RolandWa/ad8317_powermeter/emerge_results/golden/run_20260810_010924/README.md

# Golden Baseline

- Timestamp: 2026-08-10 01:09:24
- Source: User-confirmed EMerge plugin run
- Purpose: Golden reference for geometry, mesh, and result artifact comparison
- Main log file: emerge_e2e_20260810_010924_golden.log
- Touchstone: ad8317_powermeter.s2p
- Notes: This baseline includes AOI-filtered vias and explicit via geometry generation.
