RolandWa/ad8317_powermeter/doc/diagrams/out/emerge_plugin_pipeline.png

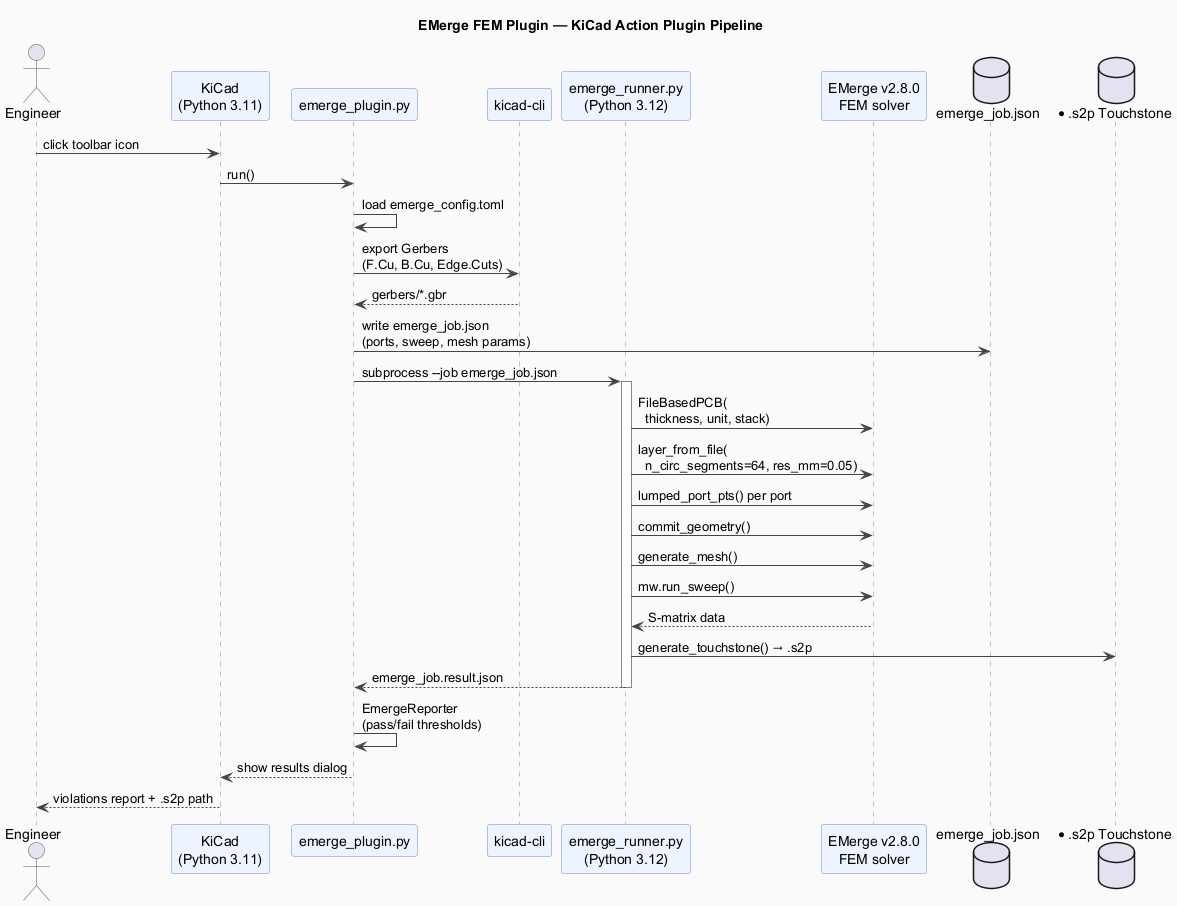
doc/diagrams/out/emerge_plugin_pipeline.png
