RolandWa/ad8317_powermeter/doc/diagrams/out/firmware_architecture.png

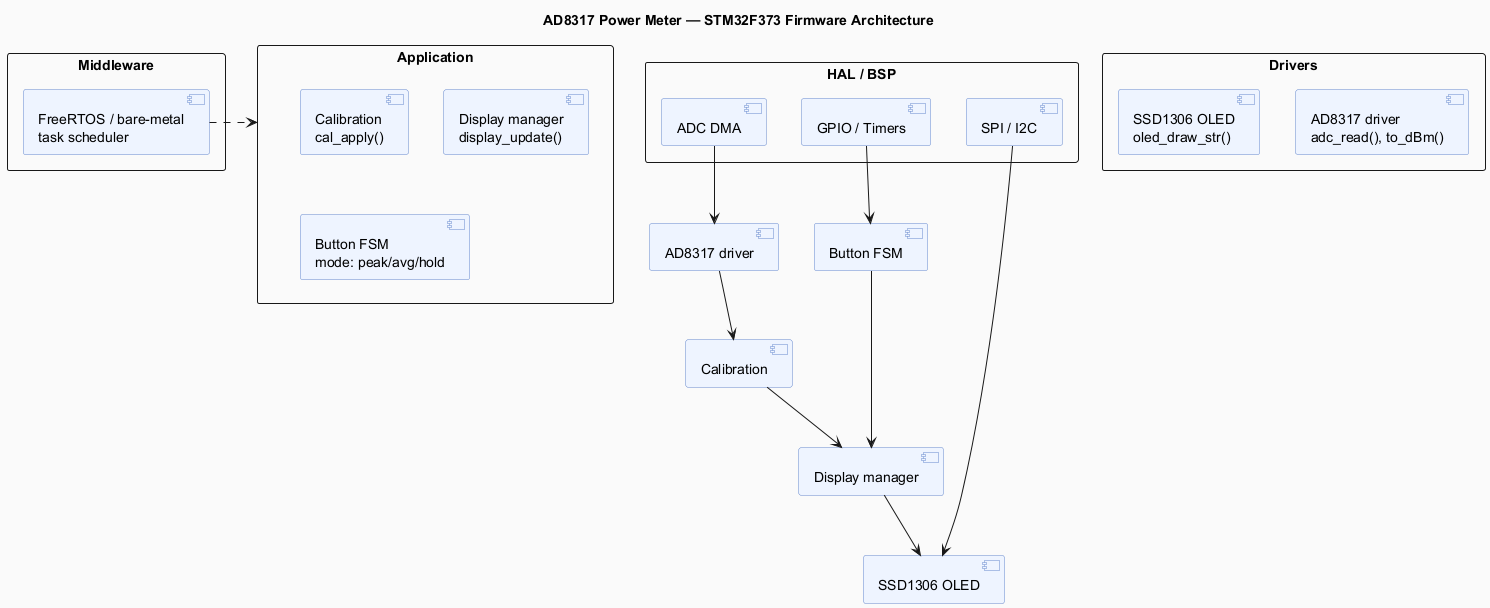
doc/diagrams/out/firmware_architecture.png
