RolandWa/ad8317_powermeter/kicad/fixture-rev_A/ad8317_powermeter-fixture.png

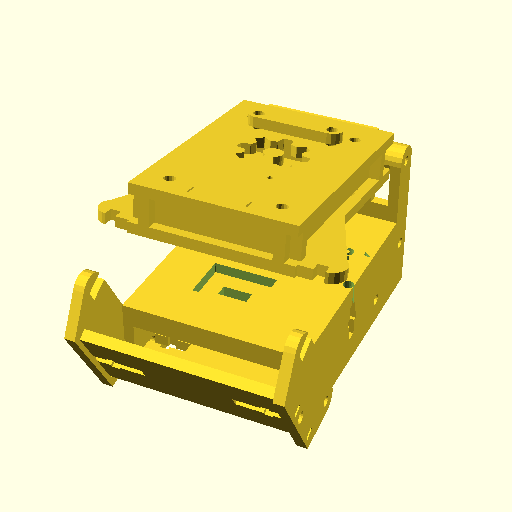
kicad/fixture-rev_A/ad8317_powermeter-fixture.png
