RolandWa/ad8317_powermeter/sim/qucs/adl5507_vs_ad8317_board.png

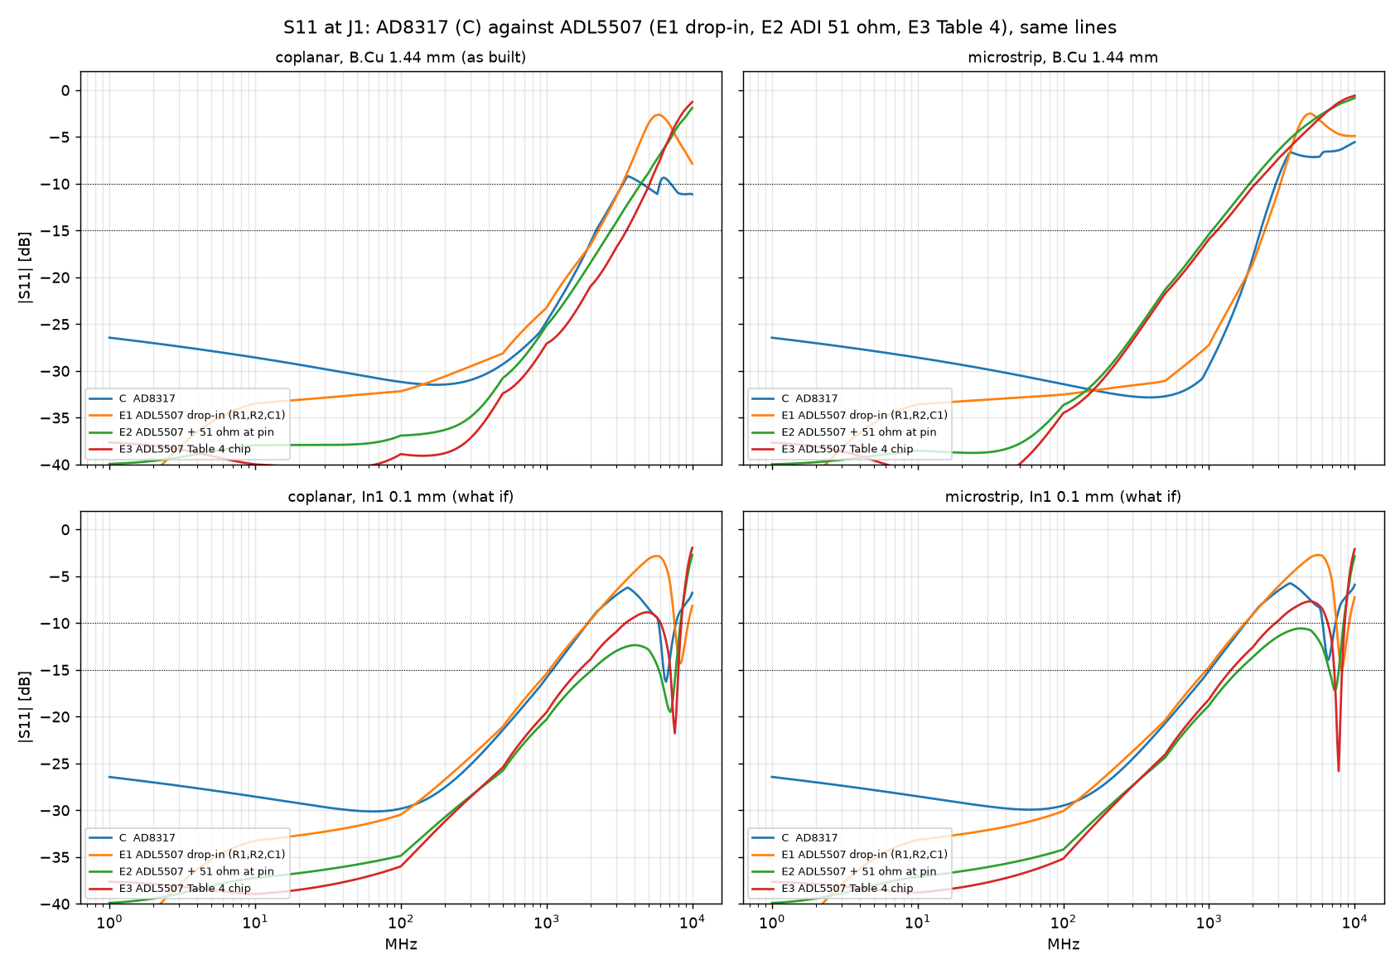
sim/qucs/adl5507_vs_ad8317_board.png
