RolandWa/ad8317_powermeter/sim/qucs/s11_1MHz_10GHz.png

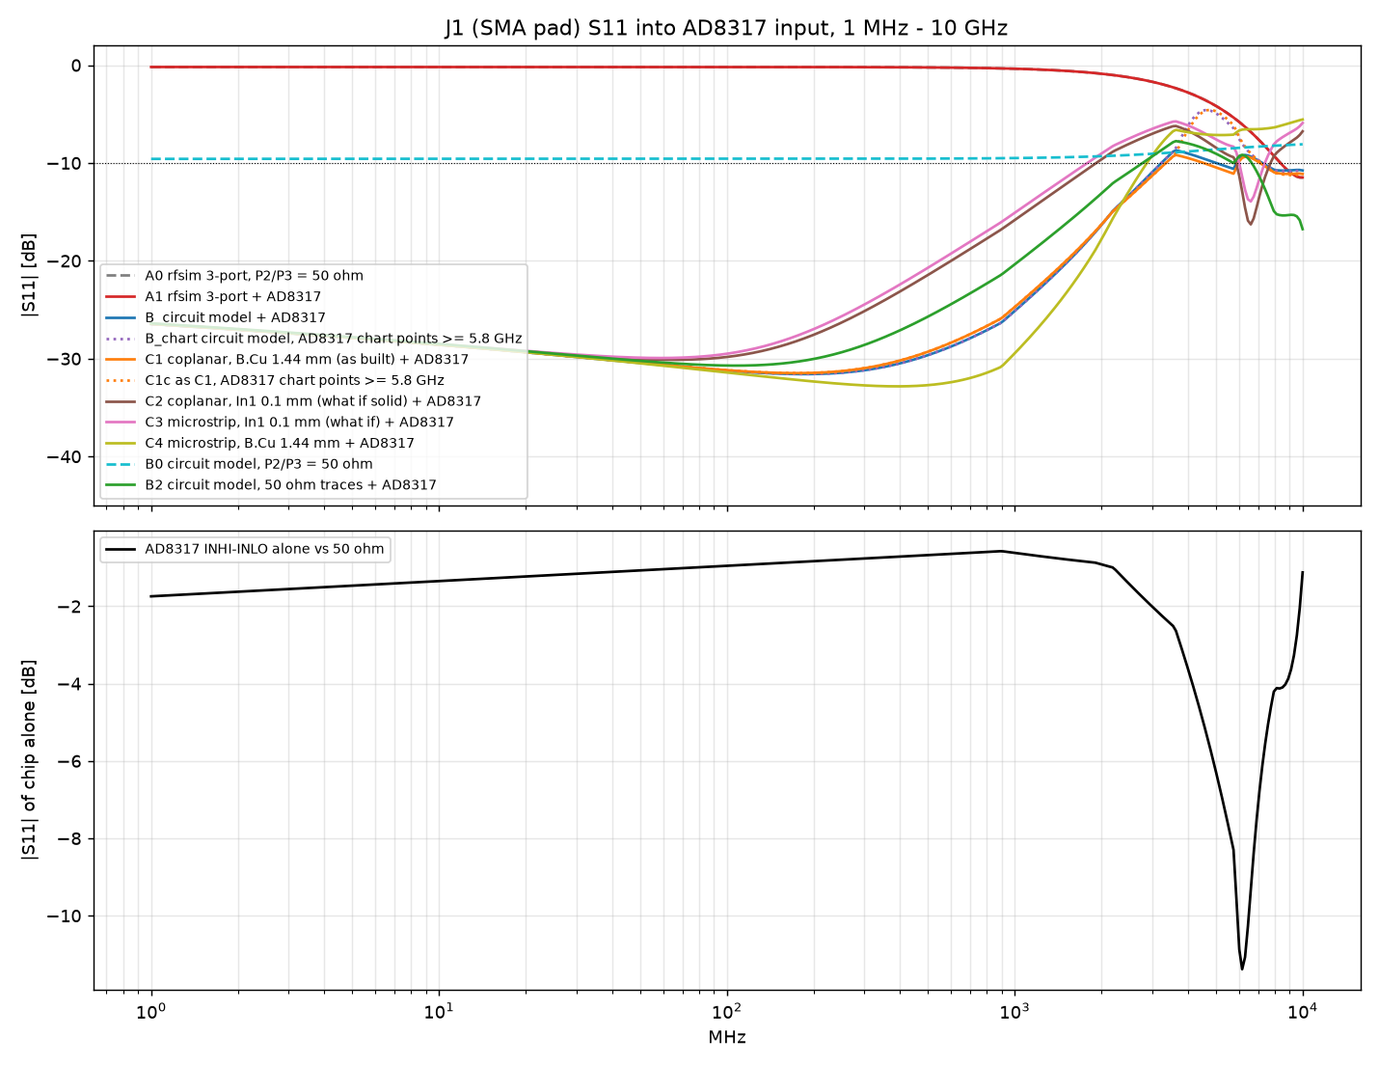
sim/qucs/s11_1MHz_10GHz.png
