RolandWa/ad8317_powermeter/sim/qucs/s11_optimized_geom_shunt_1MHz_10GHz.png

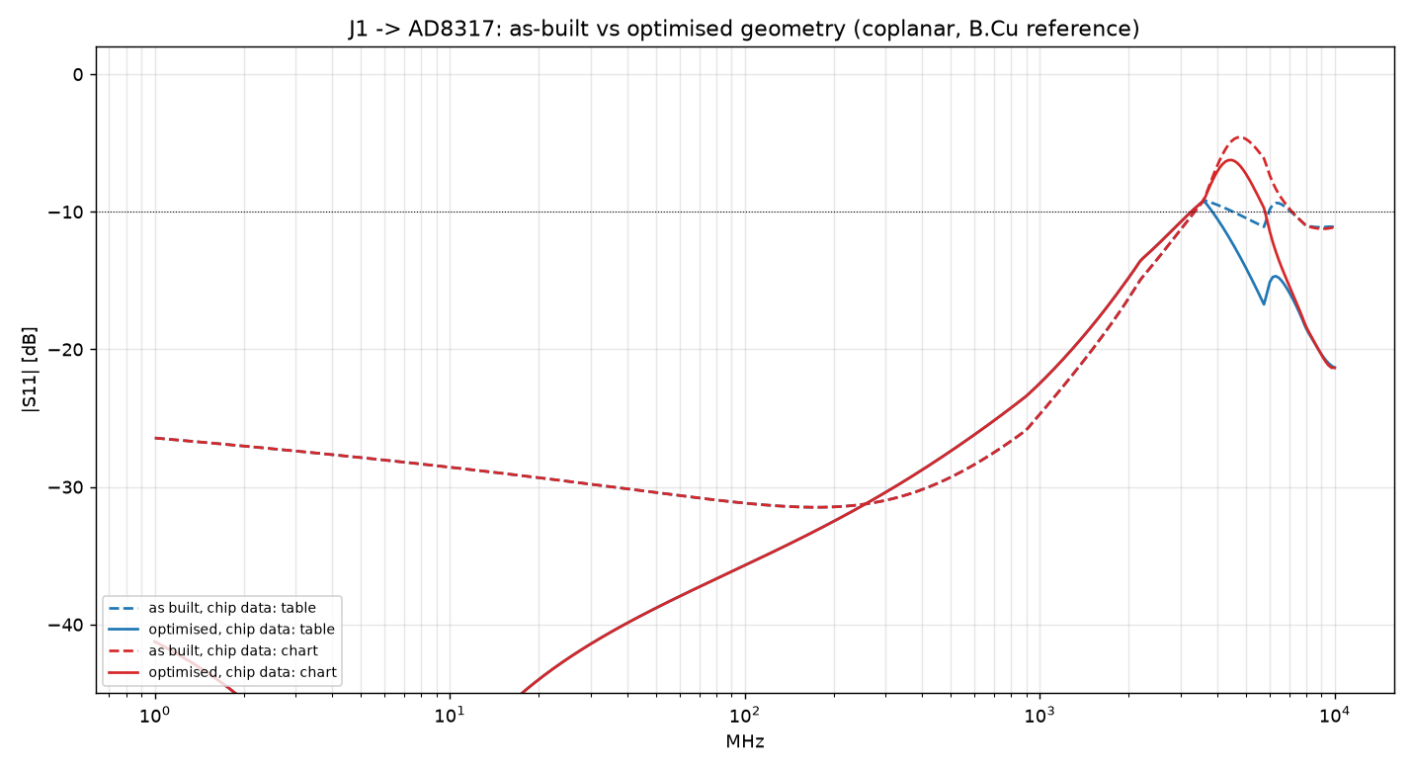
sim/qucs/s11_optimized_geom_shunt_1MHz_10GHz.png
