RolandWa/ad8317_powermeter/kicad/jlcpcb/production_files/BOM-ad8317_powermeter.csv

Comment | Designator | Footprint | LCSC | Quantity
0R | R13 | R_0402_1005Metric | C140225 | 1
100R | R1,R2 | R_0402_1005Metric | C25076 | 2
100k | R17,R18,R19,R22,R8 | R_0402_1005Metric | C25530 | 5
100nF | C10,C13,C17,C18,C19,C25,C26,C27,C30,C4,C7,C9 | C_0402_1005Metric | C9900014224 | 12
10K | R20,R23,R6 | R_0402_1005Metric | C25531 | 3
10k NTC Thermistor | R16,R21 | C_0402_1005Metric | C2892547 | 2
10uF/ | C12,C14,C15,C16,C5,C8 | C_0805_2012Metric | C1713 | 6
10uF/16V | C28,C29 | C_0805_2012Metric | C77075 | 2
12k | R5 | R_0402_1005Metric | C25752 | 1
1k | R11,R3 | R_0402_1005Metric | C9900199398 | 2
1k5 | R14,R15 | R_0402_1005Metric | C269672 | 2
1nF / C0G | C3 | C_0402_1005Metric | C76947 | 1
1uF/ | C23,C24,C31,C32 | C_0402_1005Metric | C2887021 | 4
2k | R12 | R_0402_1005Metric | C140225 | 1
4.7uF | C11 | C_0805_2012Metric | C1779 | 1
47nF | C1,C2 | C_0402_1005Metric | C880605 | 2
5K1 | R10,R9 | R_0402_1005Metric_Pad0.72x0.64mm_HandSolder | C5913162 | 2
8.2pF / C0G | C6 | C_0402_1005Metric | C1579 | 1
AD8317 | U1 | LFCSP-8-1EP_2x3mm_P0.5mm_EP1.6x2.34mm | C578693 | 1
ADP150AUJZ-3.3-R7 | U4 | TSOT-23-5 | C42432300 | 1
AP2112K-3.3 | U6 | SOT-23-5 | C51118 | 1
BQ24092DGQ | U5 | HVSSOP-10-1EP_3x3mm_P0.5mm_EP1.83x1.89mm_ThermalVias | C2864890 | 1
Conn_01x02_Pin | J4 | JST_XH_B2B-XH-AM_1x02_P2.50mm_Vertical | C161869 | 1
LED | D1,D2 | LED_0402_1005Metric | C9900022508 | 2
M24C02-WMN | U7 | SOIC-8_3.9x4.9mm_P1.27mm | C7562 | 1
REF3030 | U3 | SOT-23 | C38423 | 1
TPD4E1U06 | U8 | SOT-23-6 | C124691 | 1
USB_C_Receptacle_USB2.0_16P | J2 | USB_C_Receptacle_G-Switch_GT-USB-7010ASV |  | 1
Small_Open | JP1 | SolderJumper-2_P1.3mm_Open_RoundedPad1.0x1.5mm |  | 1
0603USB-142 | FL1 | L_CommonModeChoke_Coilcraft_0603USB |  | 1
Conn_ARM_JTAG_SWD_10_UART | J5 | PinHeader_2x05_P1.27mm_Vertical_SMD |  | 1
SW_Omron_B3FS | SW1 | SW_SPST_Omron_B3FS-100xP |  | 1
STM32F373RCTx | U2 | LQFP-64_10x10mm_P0.5mm |  | 1
Boot0 | JP2 | SolderJumper-2_P1.3mm_Open_RoundedPad1.0x1.5mm |  | 1
SW_Omron_B3FS | SW2 | SW_SPST_Omron_B3FS-100xP |  | 1
2A max / 8V max | F1 | Fuse_1812_4532Metric_Pad1.30x3.40mm_HandSolder |  | 1
RFShield_OnePiece | J6 | Laird_Technologies_BMI-S-101_13.66x12.70mm_custom |  | 1
