RolandWa/ad8317_powermeter/mech/levers/assembly_check.step

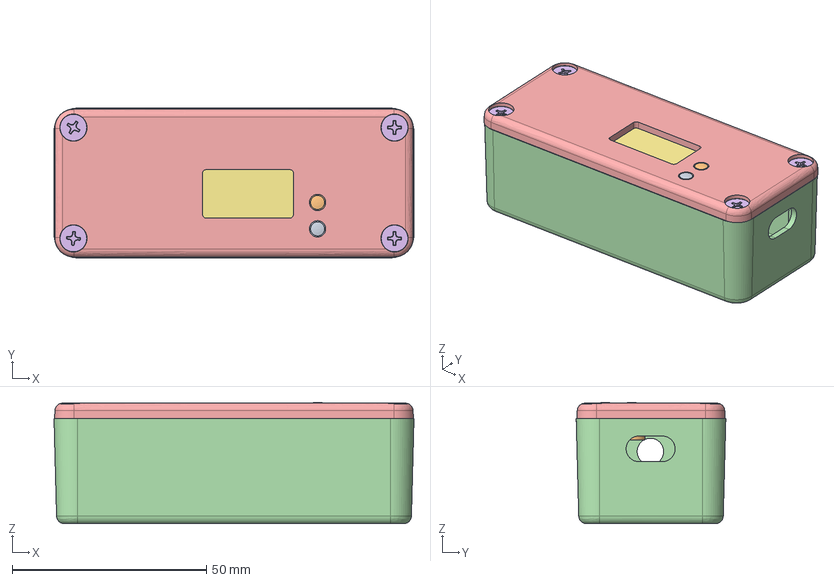
[picture p53: CAD file, 2026-10-23]
mech/levers/assembly_check.step
92.6 x 38.5 x 31.2 mm
lever_menu_SW1
lever_next_SW2
lever_bracket
case_machined
oled_module_envelope
