RolandWa/ad8317_powermeter/kicad/fixture-rev_A/ad8317_powermeter-test.dxf

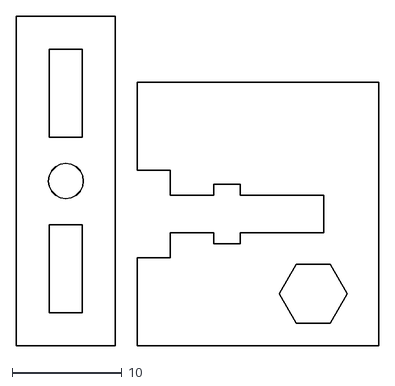
[picture p54: CAD file, 2026-08-02]
kicad/fixture-rev_A/ad8317_powermeter-test.dxf
33.0 x 30.0
