RolandWa/ad8317_powermeter/mech/cnc_wall_left_SMA.dxf

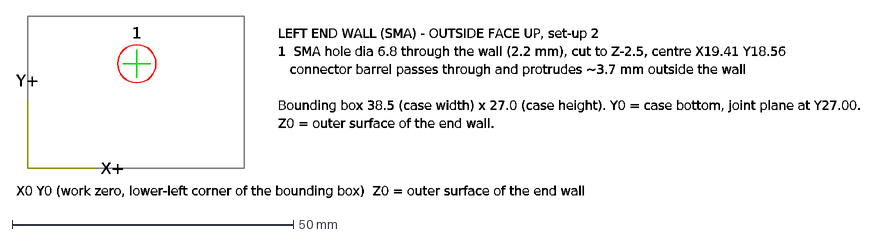
[picture p55: CAD file, 2026-10-23]
mech/cnc_wall_left_SMA.dxf
1
LEFT END WALL (SMA) - OUTSIDE FACE UP, set-up 2
1 SMA hole dia 6.8 through the wall (2.2 mm), cut to Z-2.5, centre X19.41 Y18.56
connector barrel passes through and protrudes ~3.7 mm outside the wall
Bounding box 38.5 (case width) x 27.0 (case height). Y0 = case bottom, joint plane at Y27.00.
Z0 = outer surface of the end wall.
X+
Y+
X0 Y0 (work zero, lower-left corner of the bounding box) Z0 = outer surface of the end wall
