RolandWa/ad8317_powermeter/mech/levers/levers.3mf

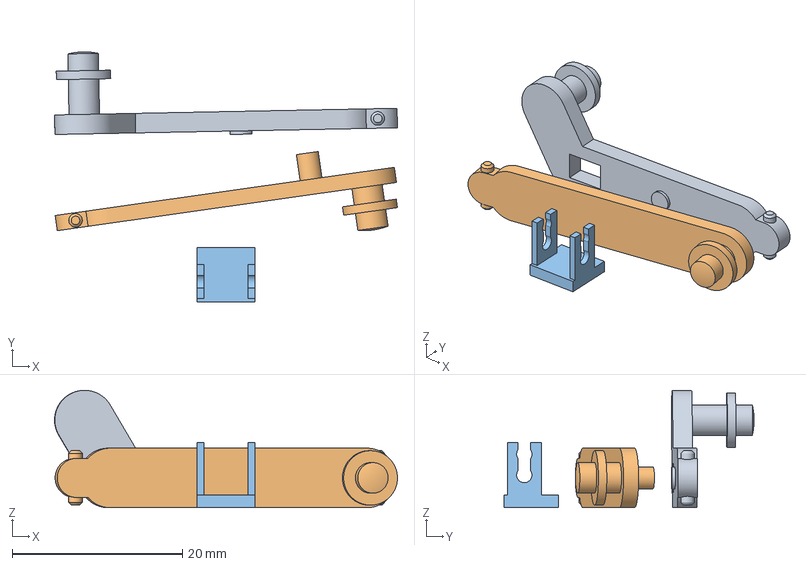
[picture p56: CAD file, 2026-10-23]
mech/levers/levers.3mf
40.3 x 29.4 x 13.8 mm
