RolandWa/ad8317_powermeter/kicad/fixture-rev_A/ad8317_powermeter-track.dxf

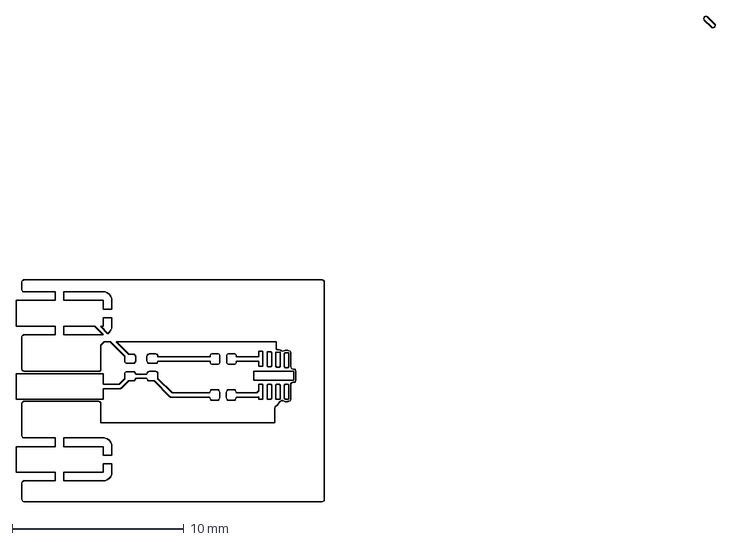
[picture p57: CAD file, 2026-08-02]
kicad/fixture-rev_A/ad8317_powermeter-track.dxf
40.7 x 28.2 mm
