RolandWa/ad8317_powermeter/mech/hammond_1590A_machined.step

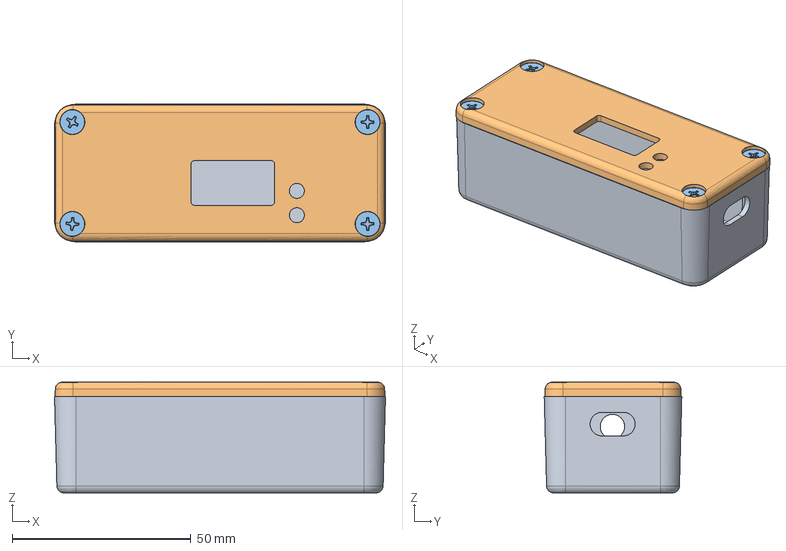
[picture p58: CAD file, 2026-10-23]
mech/hammond_1590A_machined.step
92.6 x 38.5 x 31.0 mm
