RolandWa/ad8317_powermeter/mech/levers/lever_menu_SW1.step

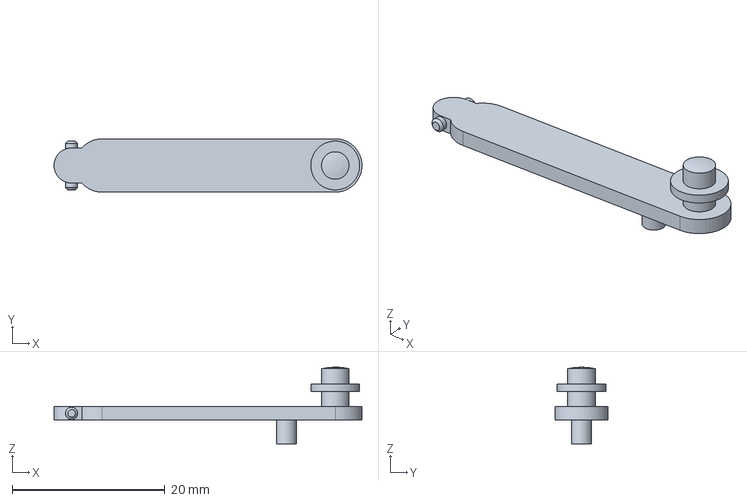
[picture p59: CAD file, 2026-10-23]
mech/levers/lever_menu_SW1.step
40.3 x 7.00 x 10.1 mm
