RolandWa/ad8317_powermeter/kicad/fixture-rev_A/ad8317_powermeter-outline.dxf

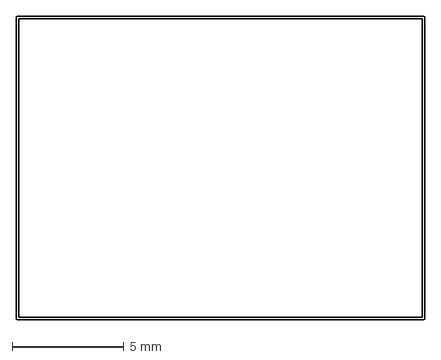
[picture p60: CAD file, 2026-08-02]
kicad/fixture-rev_A/ad8317_powermeter-outline.dxf
18.3 x 13.6 mm
