RolandWa/ad8317_powermeter/mech/cnc_wall_right_USB.dxf

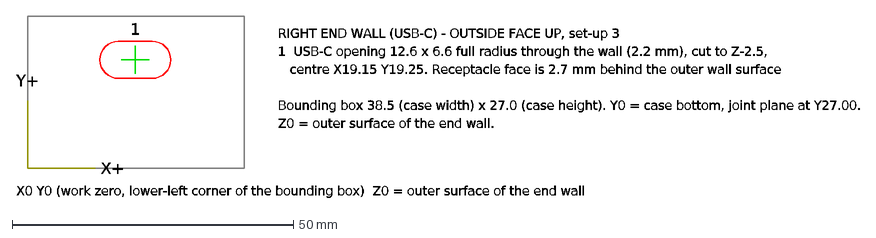
[picture p61: CAD file, 2026-10-23]
mech/cnc_wall_right_USB.dxf
1
RIGHT END WALL (USB-C) - OUTSIDE FACE UP, set-up 3
1 USB-C opening 12.6 x 6.6 full radius through the wall (2.2 mm), cut to Z-2.5,
centre X19.15 Y19.25. Receptacle face is 2.7 mm behind the outer wall surface
Bounding box 38.5 (case width) x 27.0 (case height). Y0 = case bottom, joint plane at Y27.00.
Z0 = outer surface of the end wall.
X+
Y+
X0 Y0 (work zero, lower-left corner of the bounding box) Z0 = outer surface of the end wall
