RolandWa/ad8317_powermeter/kicad/fixture-rev_A/ad8317_powermeter-fixture.dxf

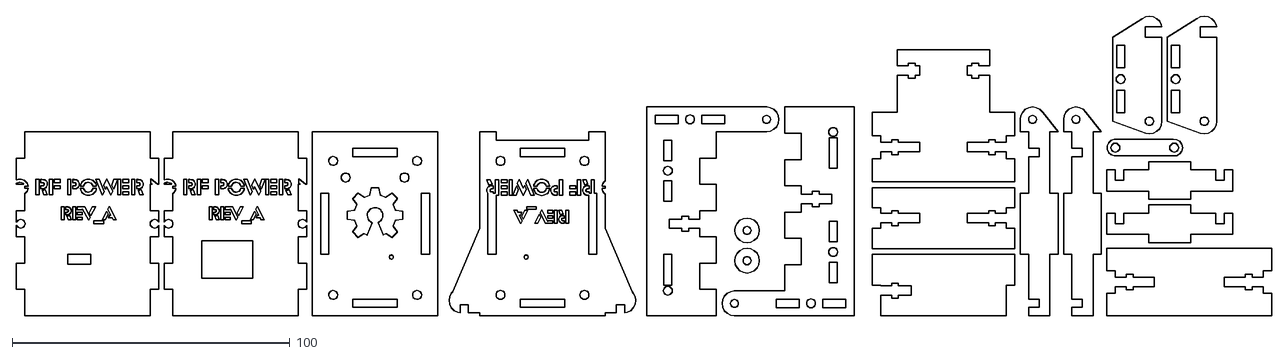
[picture p62: CAD file, 2026-08-02]
kicad/fixture-rev_A/ad8317_powermeter-fixture.dxf
451.5 x 107.7
