RolandWa/ad8317_powermeter/mech/cnc_lid_top.dxf

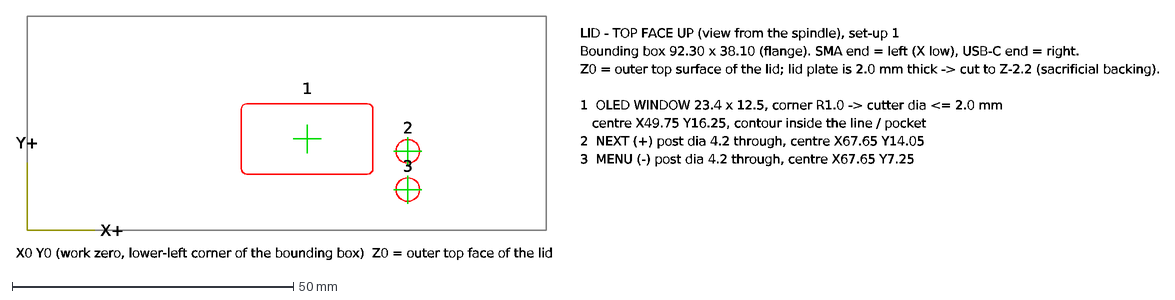
[picture p63: CAD file, 2026-10-23]
mech/cnc_lid_top.dxf
2
3
1
LID - TOP FACE UP (view from the spindle), set-up 1
Bounding box 92.30 x 38.10 (flange). SMA end = left (X low), USB-C end = right.
Z0 = outer top surface of the lid; lid plate is 2.0 mm thick -> cut to Z-2.2 (sacrificial backing).
1 OLED WINDOW 23.4 x 12.5, corner R1.0 -> cutter dia <= 2.0 mm
centre X49.75 Y16.25, contour inside the line / pocket
2 NEXT (+) post dia 4.2 through, centre X67.65 Y14.05
3 MENU (-) post dia 4.2 through, centre X67.65 Y7.25
X+
Y+
X0 Y0 (work zero, lower-left corner of the bounding box) Z0 = outer top face of the lid
