RolandWa/ad8317_powermeter/mech/levers/lever_next_SW2.step

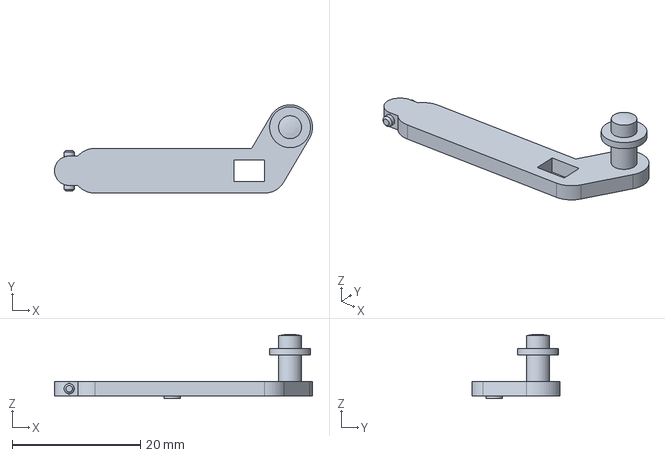
[picture p64: CAD file, 2026-10-23]
mech/levers/lever_next_SW2.step
40.3 x 13.8 x 10.1 mm
