RolandWa/ad8317_powermeter/mech/front_foil_1590A.dxf

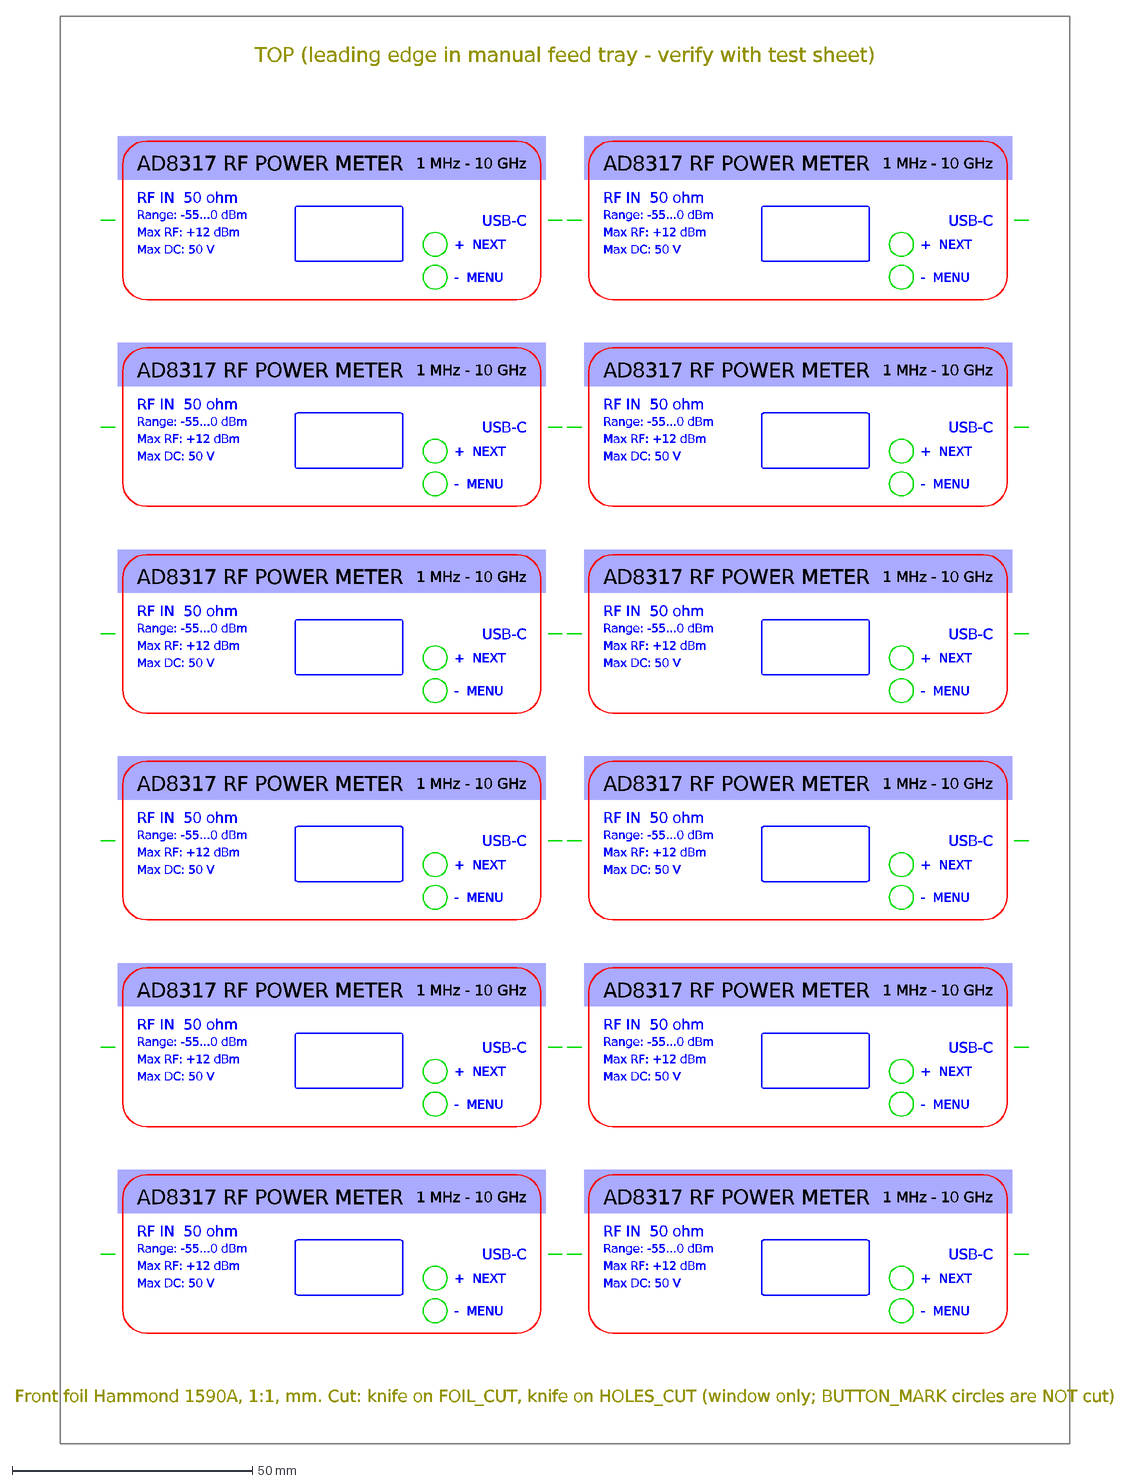
[picture p65: CAD file, 2026-10-23]
mech/front_foil_1590A.dxf
AD8317 RF POWER METER
1 MHz - 10 GHz
RF IN 50 ohm
Range: -55...0 dBm
Max RF: +12 dBm
Max DC: 50 V
USB-C
+ NEXT
- MENU
TOP (leading edge in manual feed tray - verify with test sheet)
Front foil Hammond 1590A, 1:1, mm. Cut: knife on FOIL_CUT, knife on HOLES_CUT (window only; BUTTON_MARK circles are NOT cut)
