RolandWa/ad8317_powermeter/mech/levers/lever_bracket.step

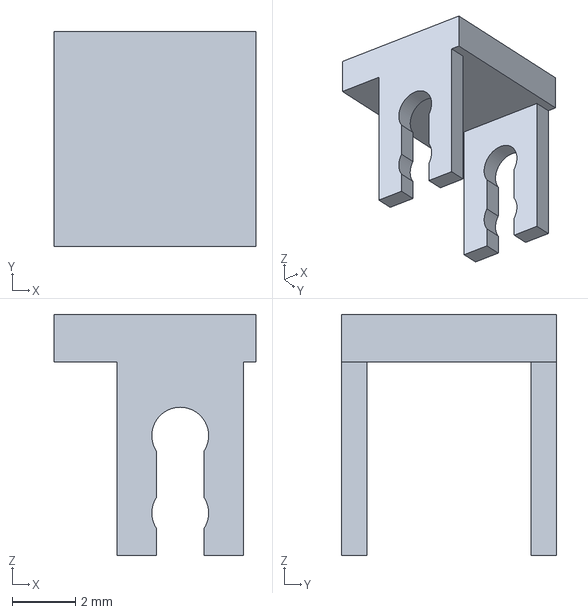
[picture p66: CAD file, 2026-10-23]
mech/levers/lever_bracket.step
6.40 x 6.80 x 7.64 mm
