RolandWa/ad8317_powermeter/(list of files, cad)

Other CAD files:
mech/levers/levers.gcode.3mf
mech/levers/lever_bracket.stl
mech/levers/lever_menu_SW1.stl
mech/levers/lever_next_SW2.stl
