RolandWa/ad8317_powermeter/mech/front_foil_1590A_test_sheet_A4.pdf

# TOP

# THIS SIDE = PRINTED SIDE (face F)

1. Take a plain A4 sheet. With a pencil draw a small arrow on ONE face, at the edge you will insert FIRST into the manual tray (this face = 'F', arrow = leading edge).
2. Load it in the manual tray exactly as you plan to load the foil
(e.g. face F up/down as the tray requires, arrow edge towards the printer).
3. Print this PDF at 100 % scale, colour.
4. Result: if the printed TOP arrow is at the pencil-arrow edge AND the print is on face F, the loading is correct. Otherwise rotate 180 deg and/or flip, repeat.
5. Load the foil the same way. The printed TOP edge = top of the sheet of foils (foil layout on the print sheet is not symmetric: header text at the top).

bar = 100 mm (measure to check print scale)
