RolandWa/ad8317_powermeter/sim/Measured_source_impedance.txt

#	Frequency (Hz)	Impedance (Ohm)	Phase (Deg)	
1	1000	0,000560552734029978	4,82452711974702
1	1071,51930523761	0,0005416886922197	7,14209337070298
1	1148,15362149688	0,000533371841688483	7,04294605382029
1	1230,26877081238	0,000539849298208619	7,04213373788446
1	1318,25673855641	0,000538129396486326	8,27278908202941
1	1412,53754462275	0,000534765524195188	8,91391828894431
1	1513,56124843621	0,000524927278521026	10,7650150981778
1	1621,81009735893	0,000518067333592301	12,6218435007175
1	1737,80082874938	0,000563457570139584	16,3469953317383
1	1862,08713666287	0,000518272901595398	14,398555985846
1	1995,26231496888	0,000519917198883852	17,0568662664533
1	2137,96208950223	0,000514601319963502	16,2707135709588
1	2290,86765276777	0,000576133502340014	19,5856516145035
1	2454,70891568503	0,000596389846115746	21,8414402405361
1	2630,26799189538	0,000532884856934725	23,7168477170005
1	2818,38293126445	0,000541318612371868	26,7012920106756
1	3019,95172040202	0,000628944117556202	22,4937176599206
1	3235,93656929628	0,000573547161269501	28,2921698624638
1	3467,36850452532	0,000597200960721228	30,4654517183948
1	3715,35229097172	0,000619368975789402	31,6169105015001
1	3981,07170553497	0,000707127470434435	33,1952184102704
1	4265,79518801593	0,000658666852178837	32,4537477221939
1	4570,88189614875	0,000607535285895156	31,0642288773697
1	4897,78819368446	0,00065802335701887	34,3164048480271
1	5248,07460249772	0,000631190138287628	37,694095890147
1	5623,41325190349	0,000633797750820474	40,4545209404637
1	6025,59586074358	0,000665723443822306	43,8796093297793
1	6456,54229034656	0,000736064761026864	46,102881890377
1	6918,30970918936	0,000782103178029204	49,5549261550406
1	7413,10241300918	0,000851706901337979	51,2162462238737
1	7943,28234724281	0,000898955659891943	52,9247825025595
1	8511,38038202376	0,000947196650326792	50,2553545067154
1	9120,1083935591	0,00104276493305608	54,9674727922125
1	9772,37220955811	0,00109952852709957	56,0489569531524
1	10471,285480509	0,00119376421446782	56,8203613736253
1	11220,1845430196	0,0012856894876208	57,149986225213
1	12022,6443461741	0,00138201268098962	57,6040616579294
1	12882,4955169313	0,00149019184356974	57,2980602121534
1	13803,8426460288	0,00159326348179086	57,2581168269142
1	14791,0838816821	0,00171810849886565	57,1610545940367
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
