RolandWa/ad8317_powermeter/sim/qucs/s11_results.csv

freq_Hz | A0_dB | A1_dB | B_dB | B_chart_dB | C1_dB | C1c_dB | C2_dB | C3_dB | C4_dB | B0_dB | B2_dB
1.000000e+06 | -0.190 | -0.190 | -26.465 | -26.465 | -26.446 | -26.446 | -26.443 | -26.435 | -26.448 | -9.584 | -26.391
1.023293e+06 | -0.190 | -0.190 | -26.484 | -26.484 | -26.465 | -26.465 | -26.462 | -26.454 | -26.466 | -9.584 | -26.409
1.047129e+06 | -0.190 | -0.190 | -26.502 | -26.502 | -26.484 | -26.484 | -26.480 | -26.472 | -26.485 | -9.583 | -26.428
1.071519e+06 | -0.190 | -0.190 | -26.521 | -26.521 | -26.502 | -26.502 | -26.499 | -26.491 | -26.504 | -9.583 | -26.446
1.096478e+06 | -0.190 | -0.190 | -26.540 | -26.540 | -26.521 | -26.521 | -26.518 | -26.509 | -26.523 | -9.583 | -26.465
1.122018e+06 | -0.190 | -0.190 | -26.559 | -26.559 | -26.540 | -26.540 | -26.537 | -26.528 | -26.541 | -9.582 | -26.483
1.148154e+06 | -0.190 | -0.190 | -26.578 | -26.578 | -26.559 | -26.559 | -26.555 | -26.547 | -26.560 | -9.582 | -26.502
1.174898e+06 | -0.190 | -0.190 | -26.597 | -26.597 | -26.578 | -26.578 | -26.574 | -26.565 | -26.579 | -9.582 | -26.521
1.202264e+06 | -0.190 | -0.190 | -26.616 | -26.616 | -26.597 | -26.597 | -26.593 | -26.584 | -26.598 | -9.581 | -26.540
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
