RolandWa/ad8317_powermeter/cal/results/figures/fig2_slope_vs_freq.png

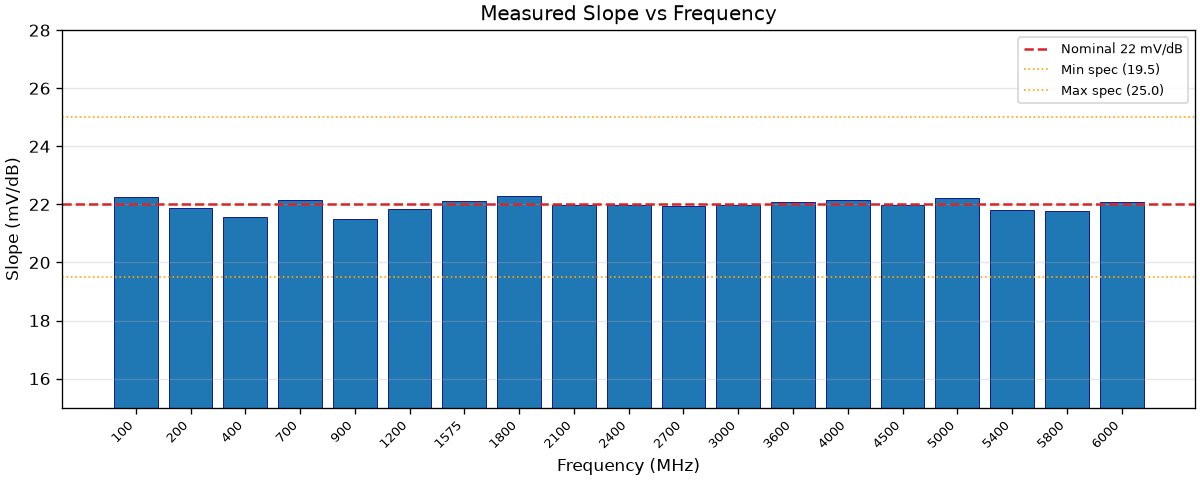
cal/results/figures/fig2_slope_vs_freq.png
