RolandWa/ad8317_powermeter/cal/results/figures/fig3_intercept_vs_freq.png

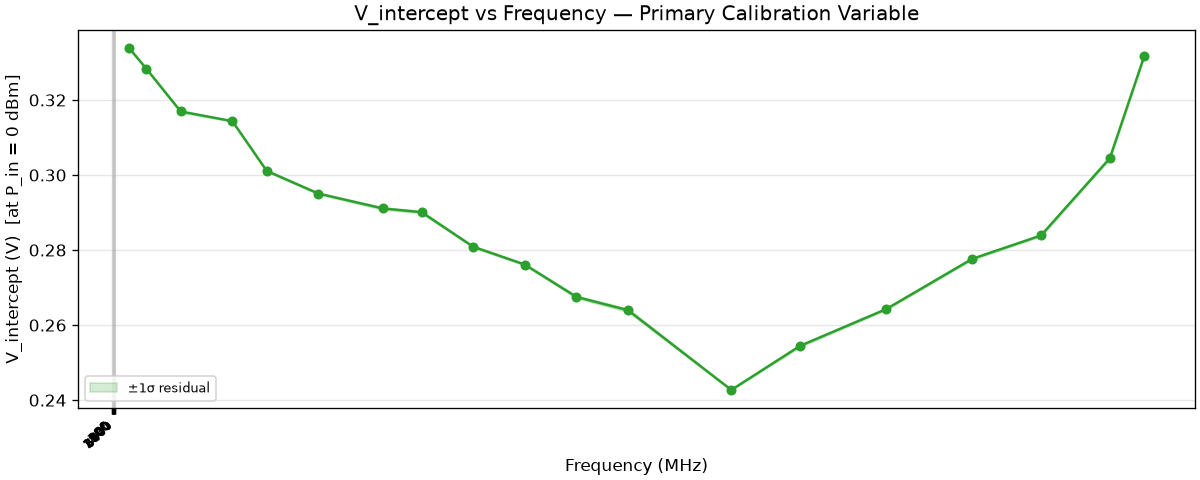
cal/results/figures/fig3_intercept_vs_freq.png
