RolandWa/ad8317_powermeter/cal/results/figures/fig4_residual_rms.png

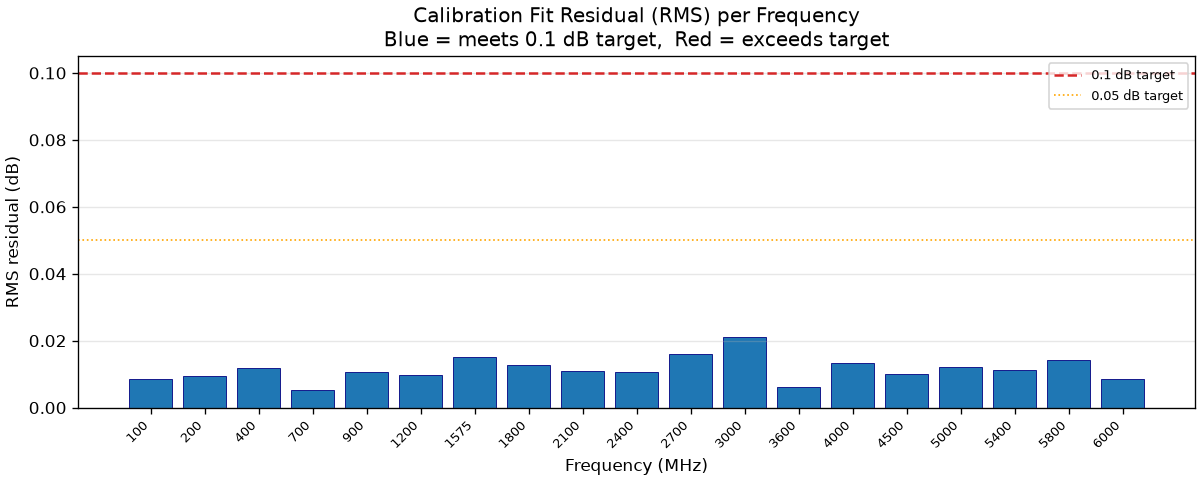
cal/results/figures/fig4_residual_rms.png
