RolandWa/ad8317_powermeter/cal/results/figures/fig5_error_heatmap.png

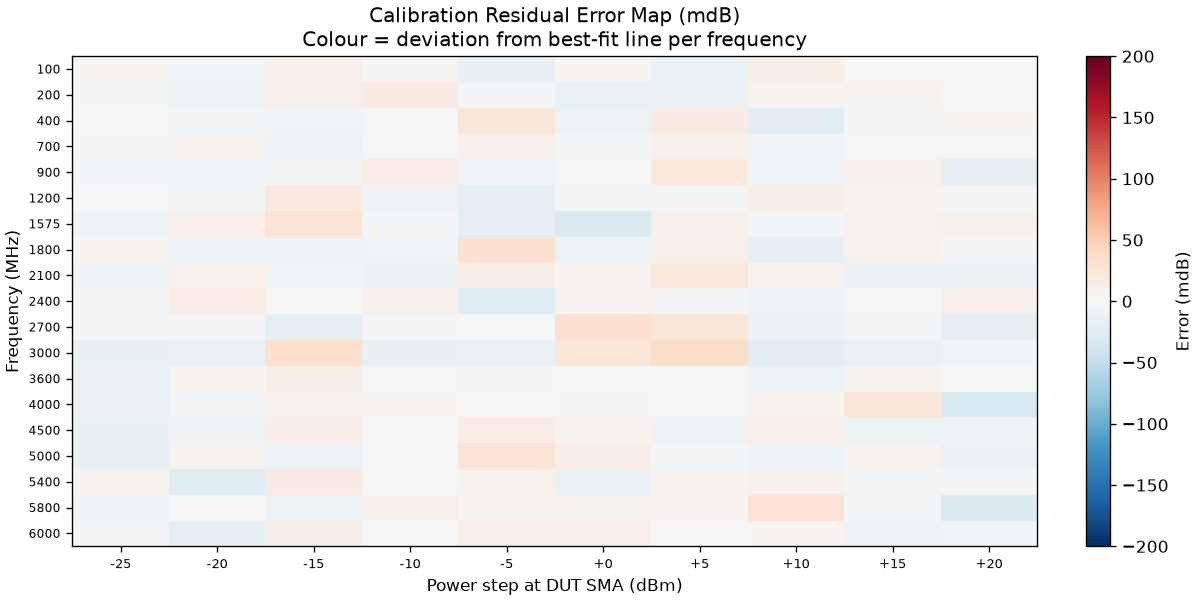
cal/results/figures/fig5_error_heatmap.png
