RolandWa/ad8317_powermeter/sim/Measured_source_impedance_impedance.png

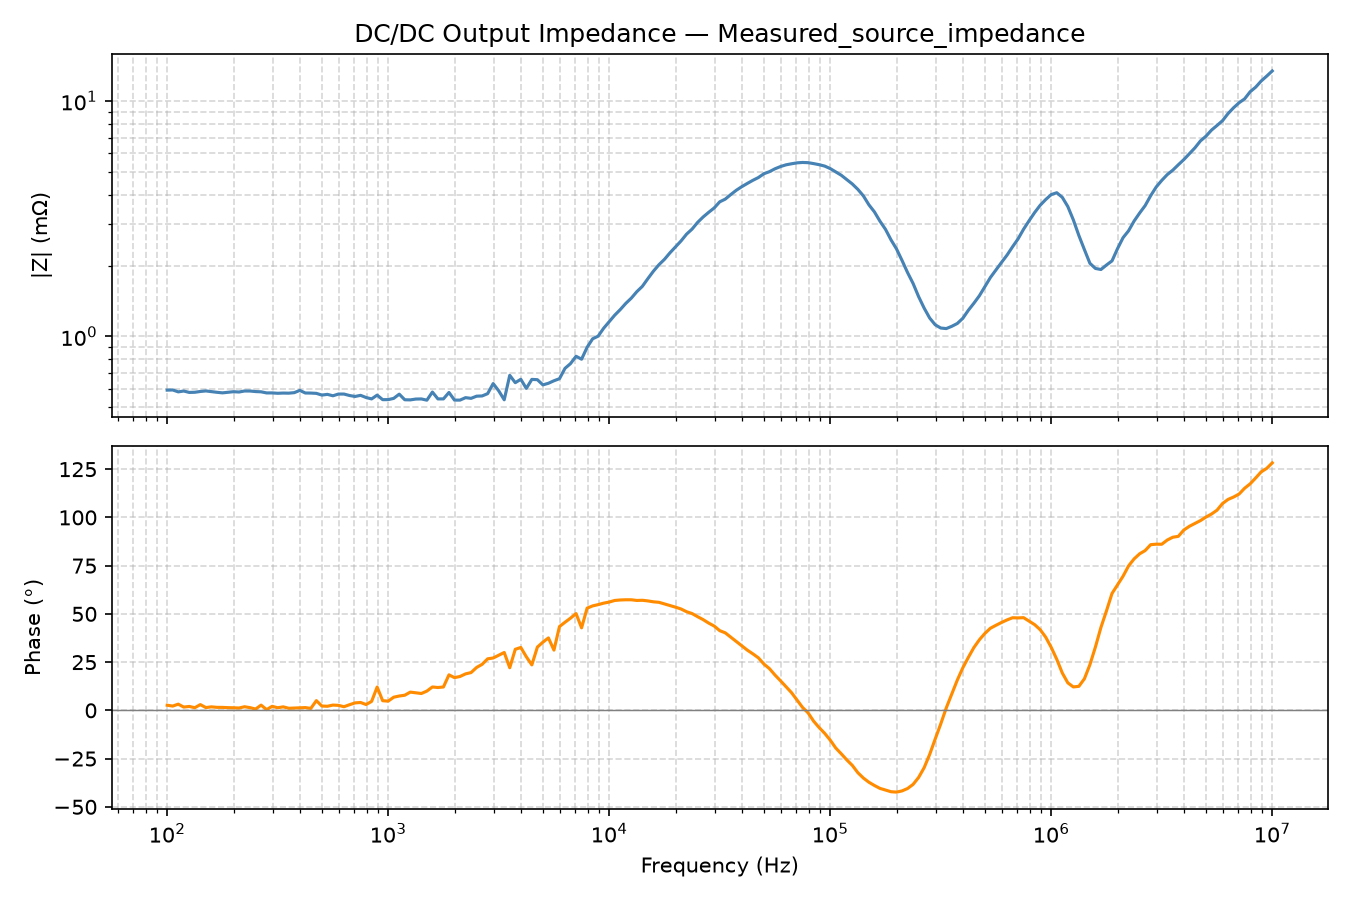
sim/Measured_source_impedance_impedance.png
