RolandWa/ad8317_powermeter/mech/front_foil_1590A_print_A4.pdf

AD8317 RF POWER METER | 1 MHz - 10 GHz

### RF IN 50 ohm

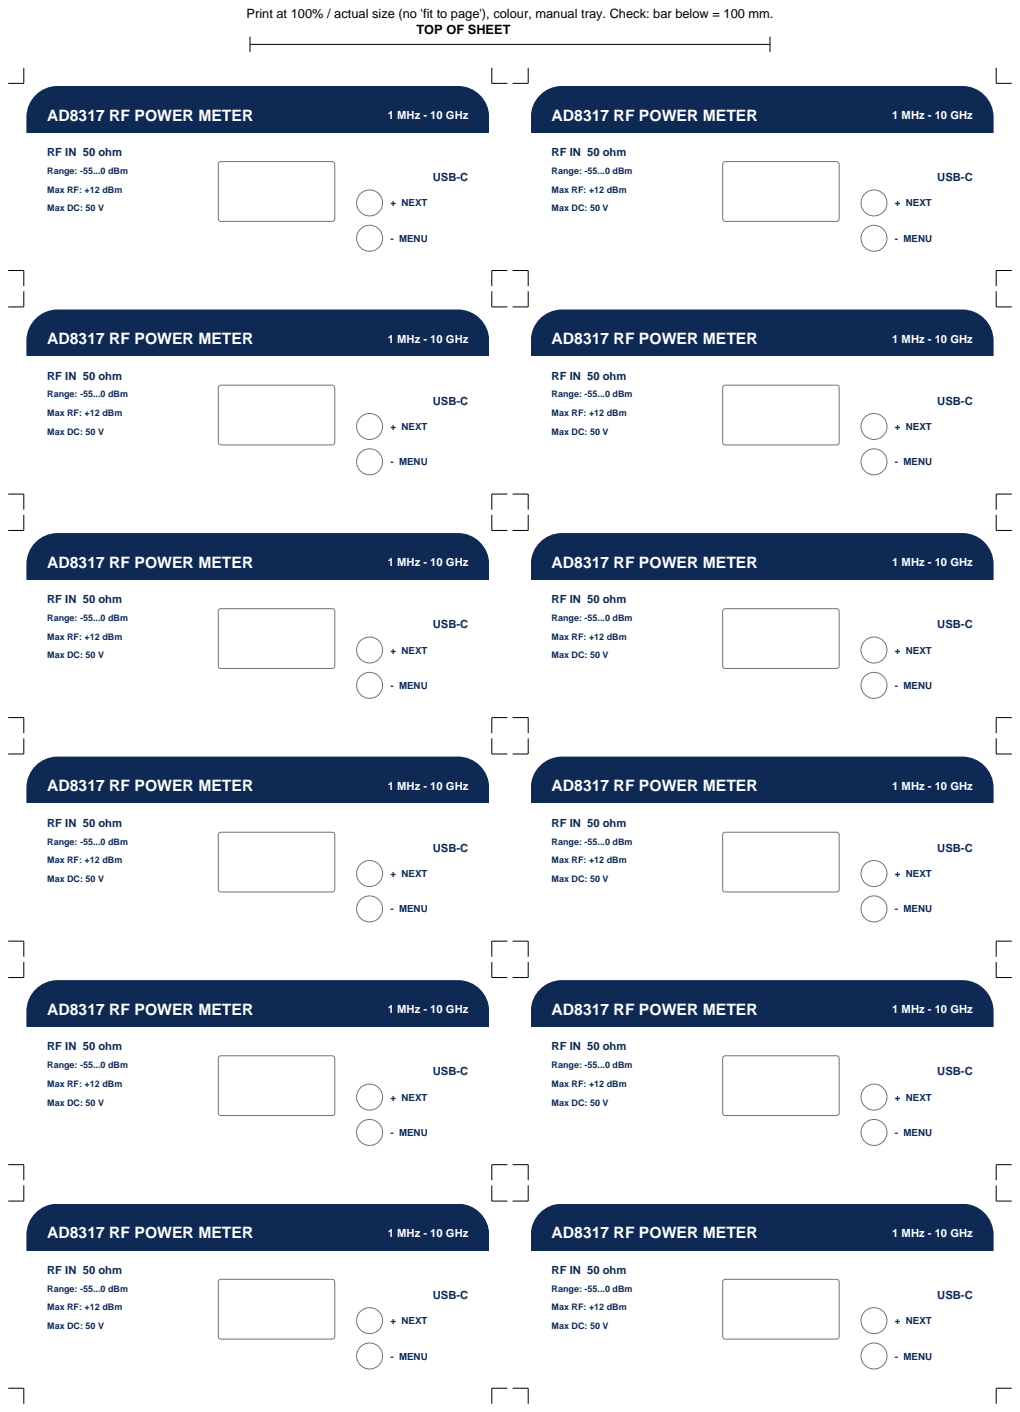
[picture p83: page 1]
USB-C; + NEXT; - MENU; AD8317 RF POWER METER; 1 MHz - 10 GHz

Print at 100% / actual size (no 'fit to page'), colour, manual tray. Check: bar below = 100 mm.

TOP OF SHEET

RF IN 50 ohm
Range: -55...0 dBm
Max RF: +12 dBm
Max DC: 50 V
