RolandWa/ad8317_powermeter/kicad/jlcpcb/production_files/Schematic-ad8317_powermeter.pdf

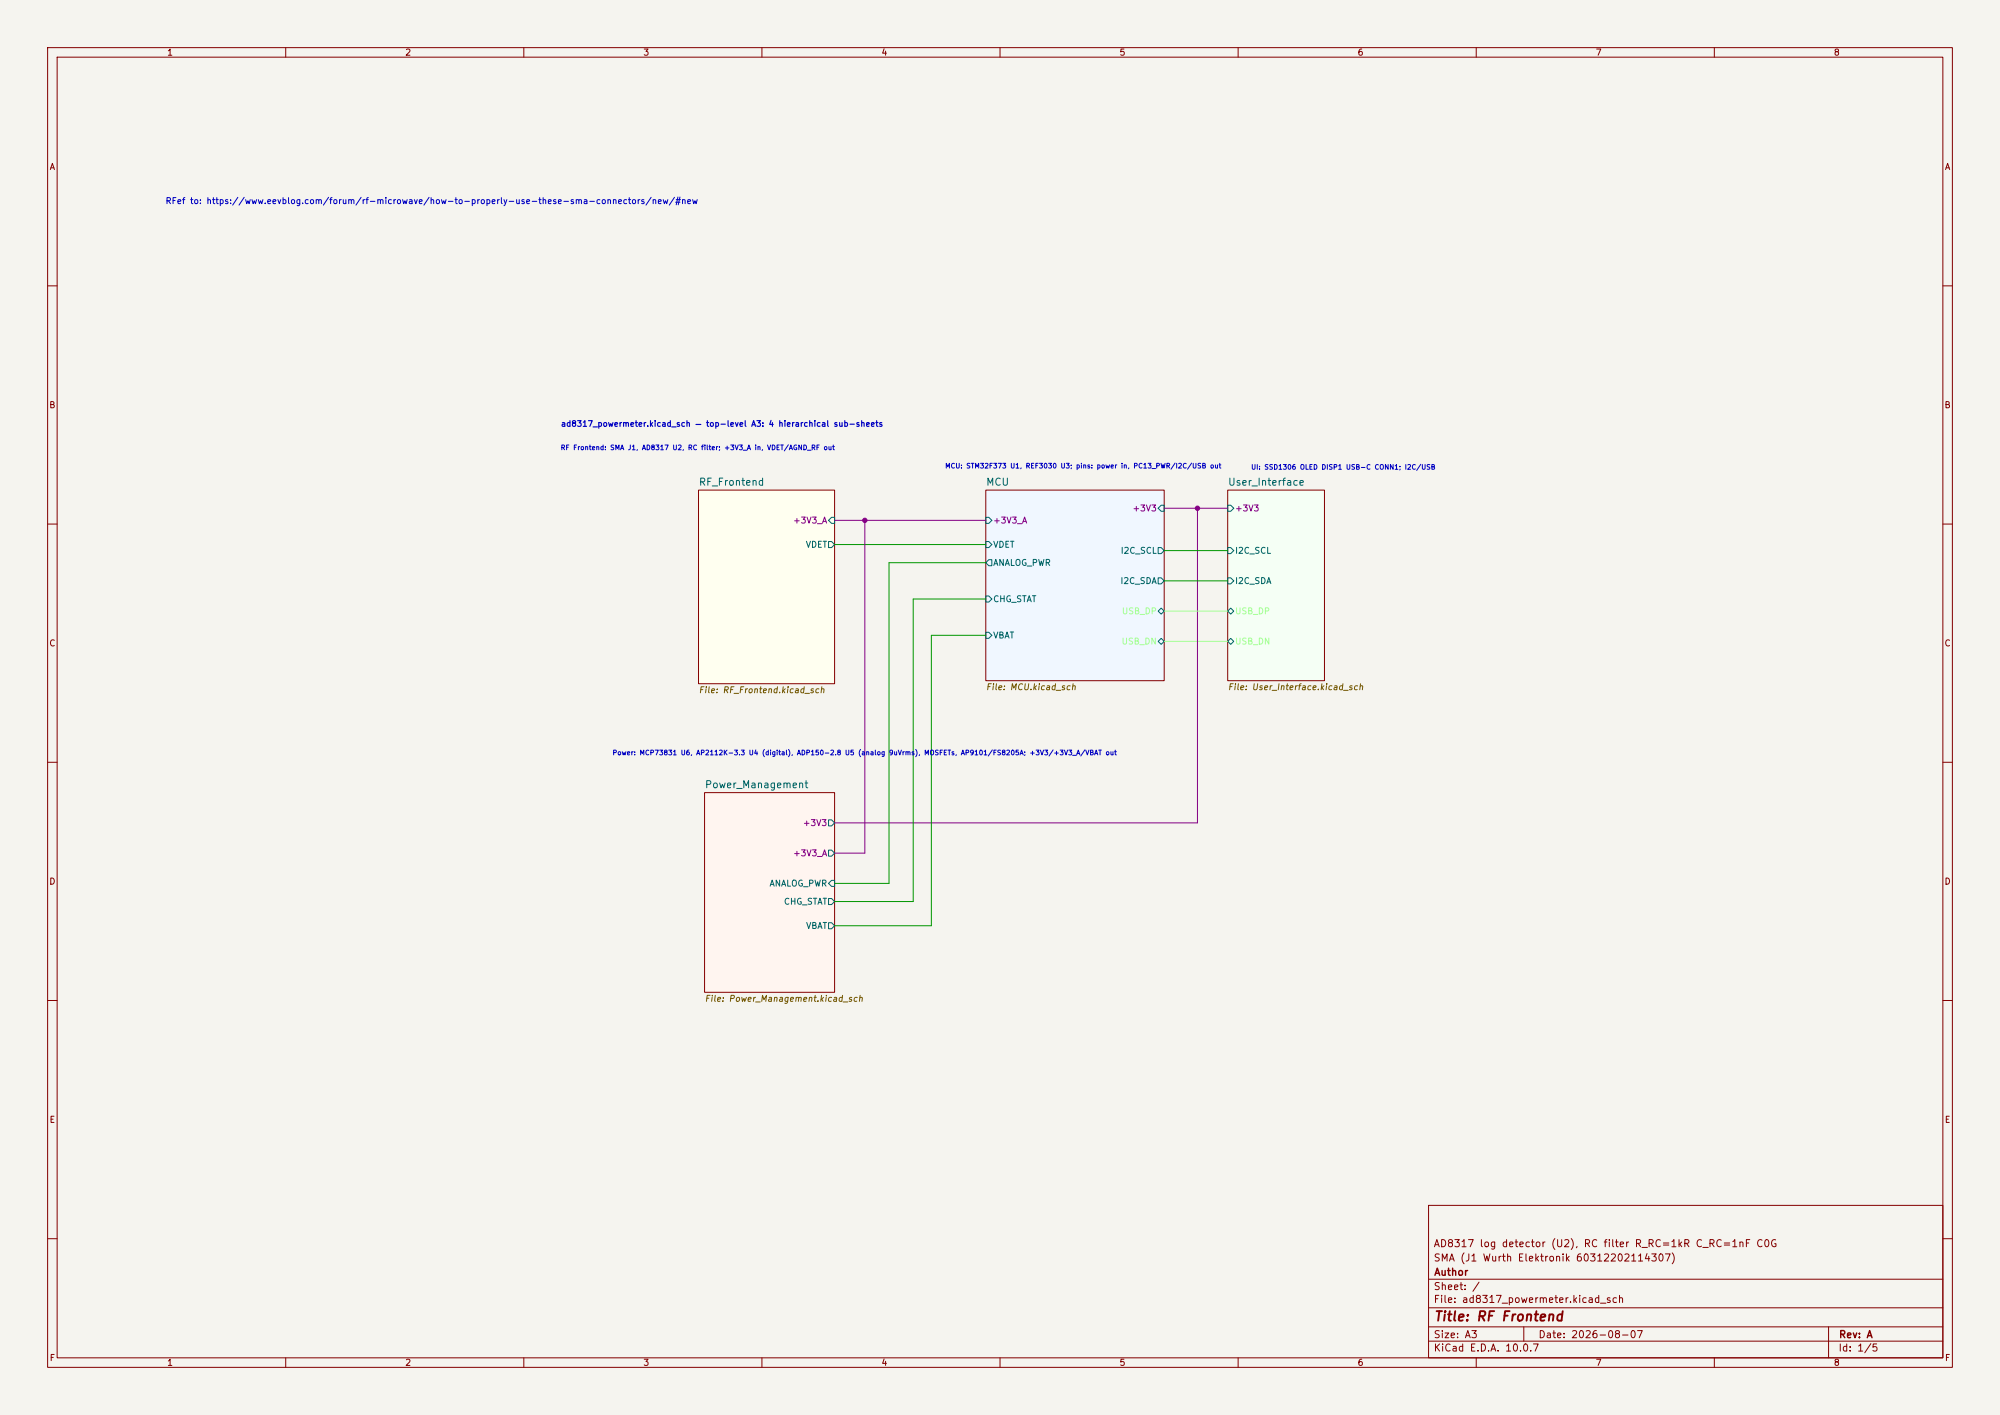
[picture p84: page 1]

RF Frontend: SMA J1, AD8317 U2, RC filter; +3V3_A in, VDET/AGND_RF out RFef to: https://www.eevblog.com/forum/rf-microwave/how-to-properly-use-these-sma-connectors/new/#new

UI: SSD1306 OLED DISP1 USB-C CONN1; I2C/USB
I2C_SDA +3V3 USB_DP USB_DN User_Interface

AD8317 log detector (U2), RC filter R_RC=1kR C_RC=1nF C0G
SMA (J1 Wurth Elektronik 60312202114307)
Author
Sheet: /
File: ad8317_powermeter.kicad_sch
Title: RF Frontend

Size: A3 | Rev: A | F Date: 2026-08-07
KiCad E.D.A. 10.0.7 | Id: 1/5

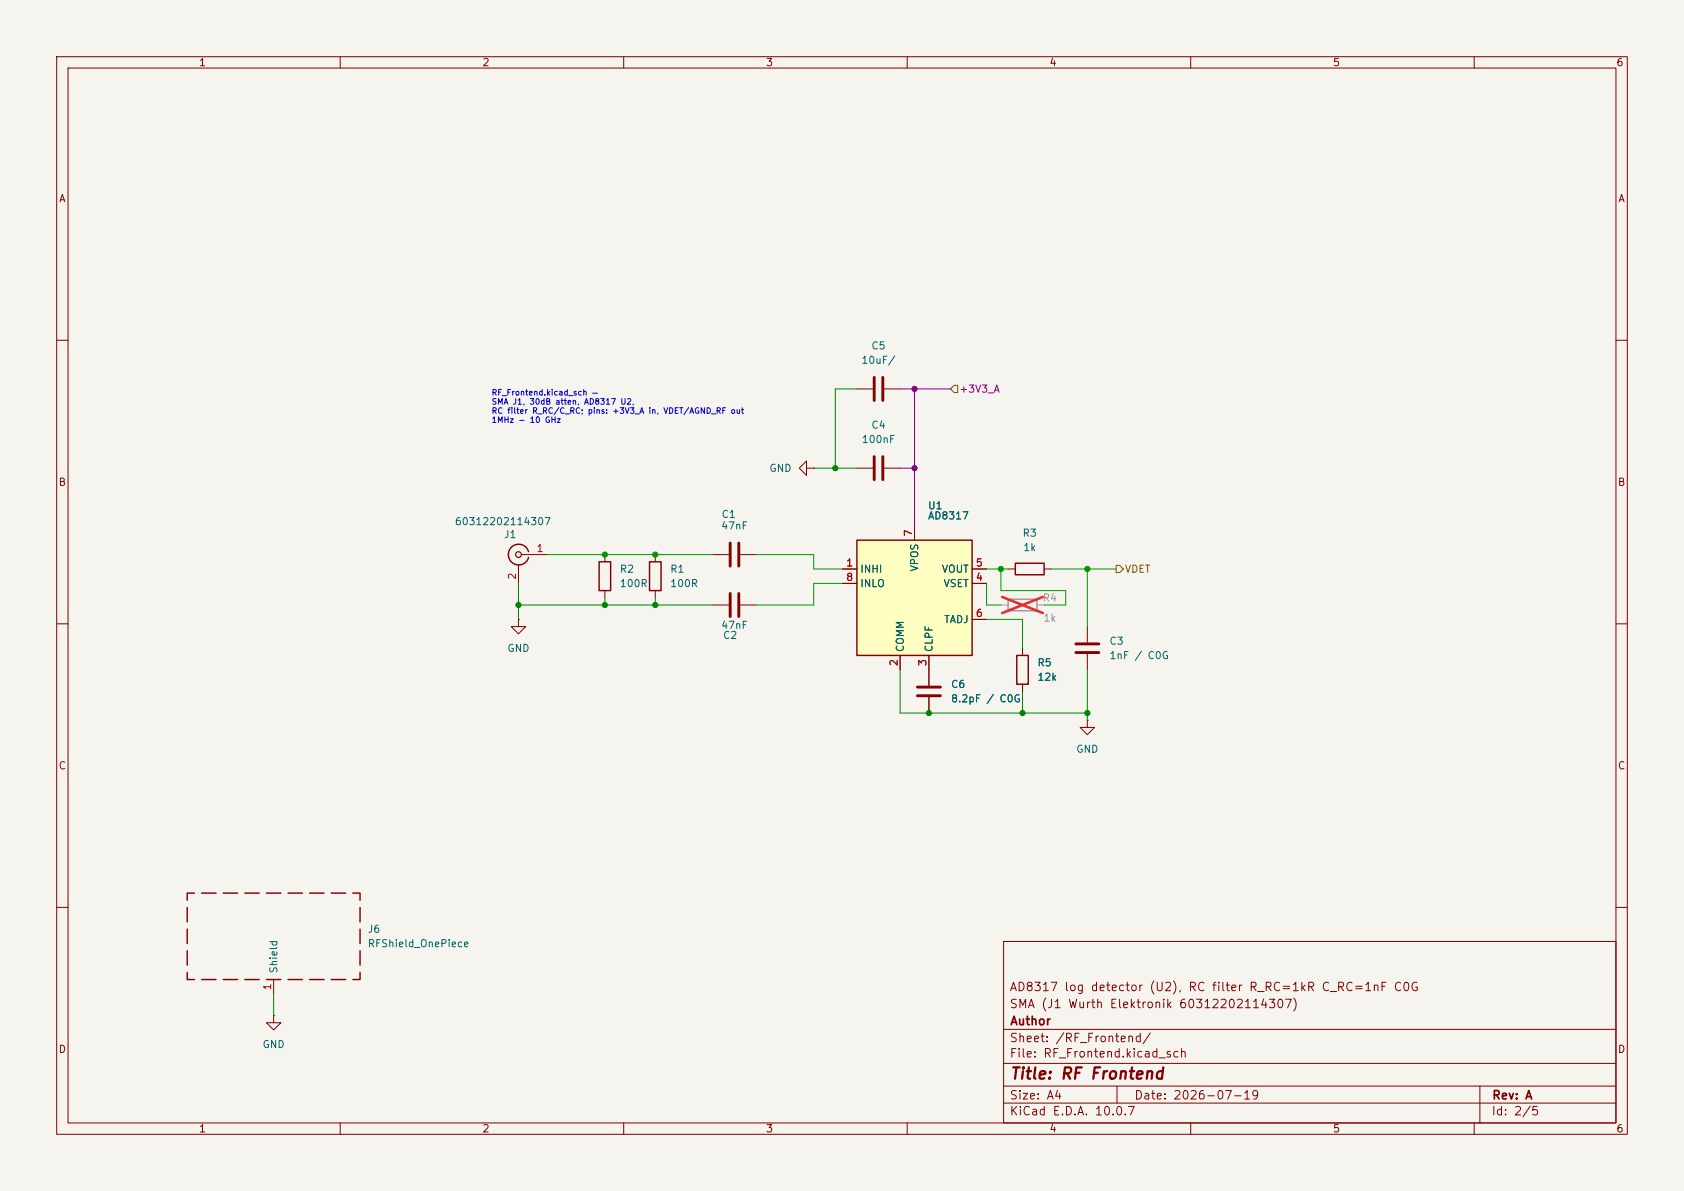
[picture p85: page 2]

J6RFShield_OnePiece GND
AD8317 log detector (U2), RC filter R_RC=1kR C_RC=1nF C0G Shield 1

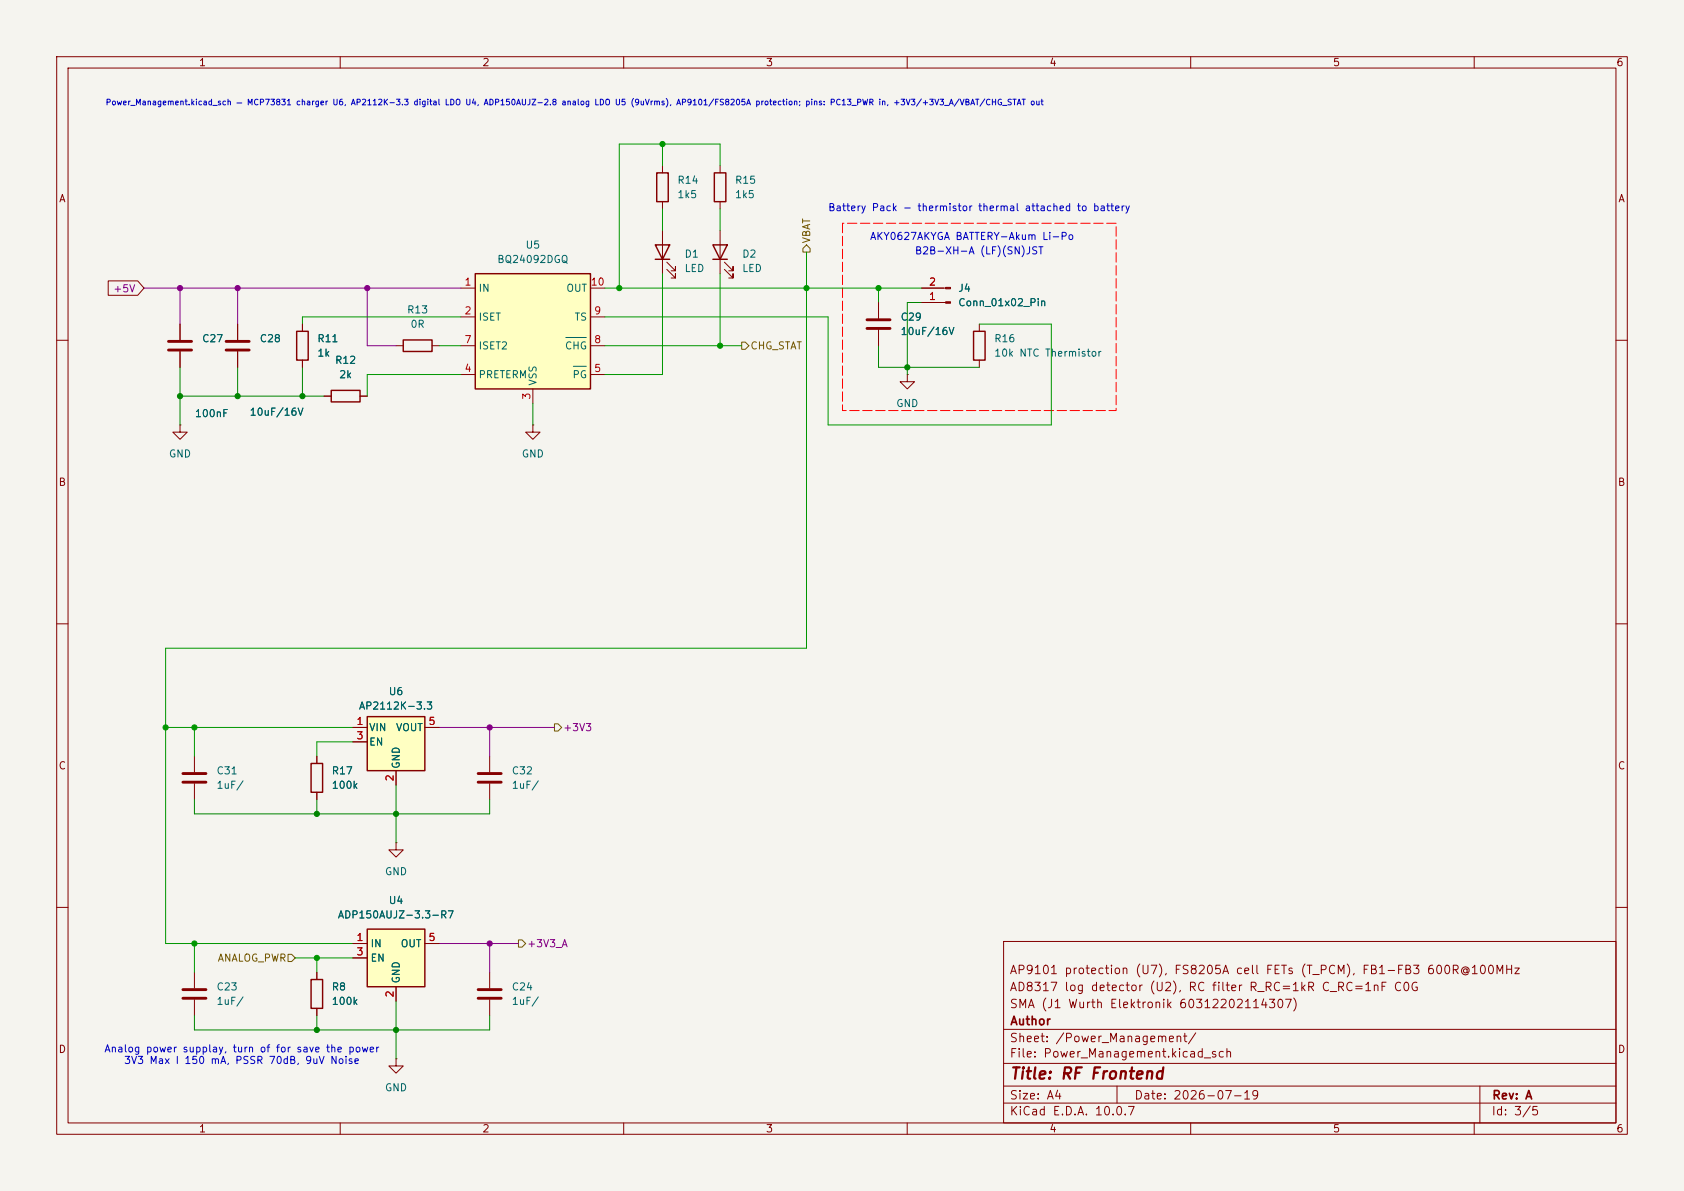
[picture p86: page 3]

Power_Management.kicad_sch — MCP73831 charger U6, AP2112K-3.3 digital LDO U4, ADP150AUJZ-2.8 analog LDO U5 (9uVrms), AP9101/FS8205A protection; pins: PC13_PWR in, +3V3/+3V3_A/VBAT/CHG_STAT out

Battery Pack - thermistor thermal attached to battery AKY0627AKYGA BATTERY-Akum Li-Po

B2B-XH-A (LF)(SN)JST

AP9101 protection (U7), FS8205A cell FETs (T_PCM), FB1-FB3 600R@100MHz
AD8317 log detector (U2), RC filter R_RC=1kR C_RC=1nF C0G
SMA (J1 Wurth Elektronik 60312202114307)
Author
Sheet: /Power_Management/
File: Power_Management.kicad_sch
Title: RF Frontend

Analog power supplay, turn of for save the power 3V3 Max I 150 mA, PSSR 70dB, 9uV Noise

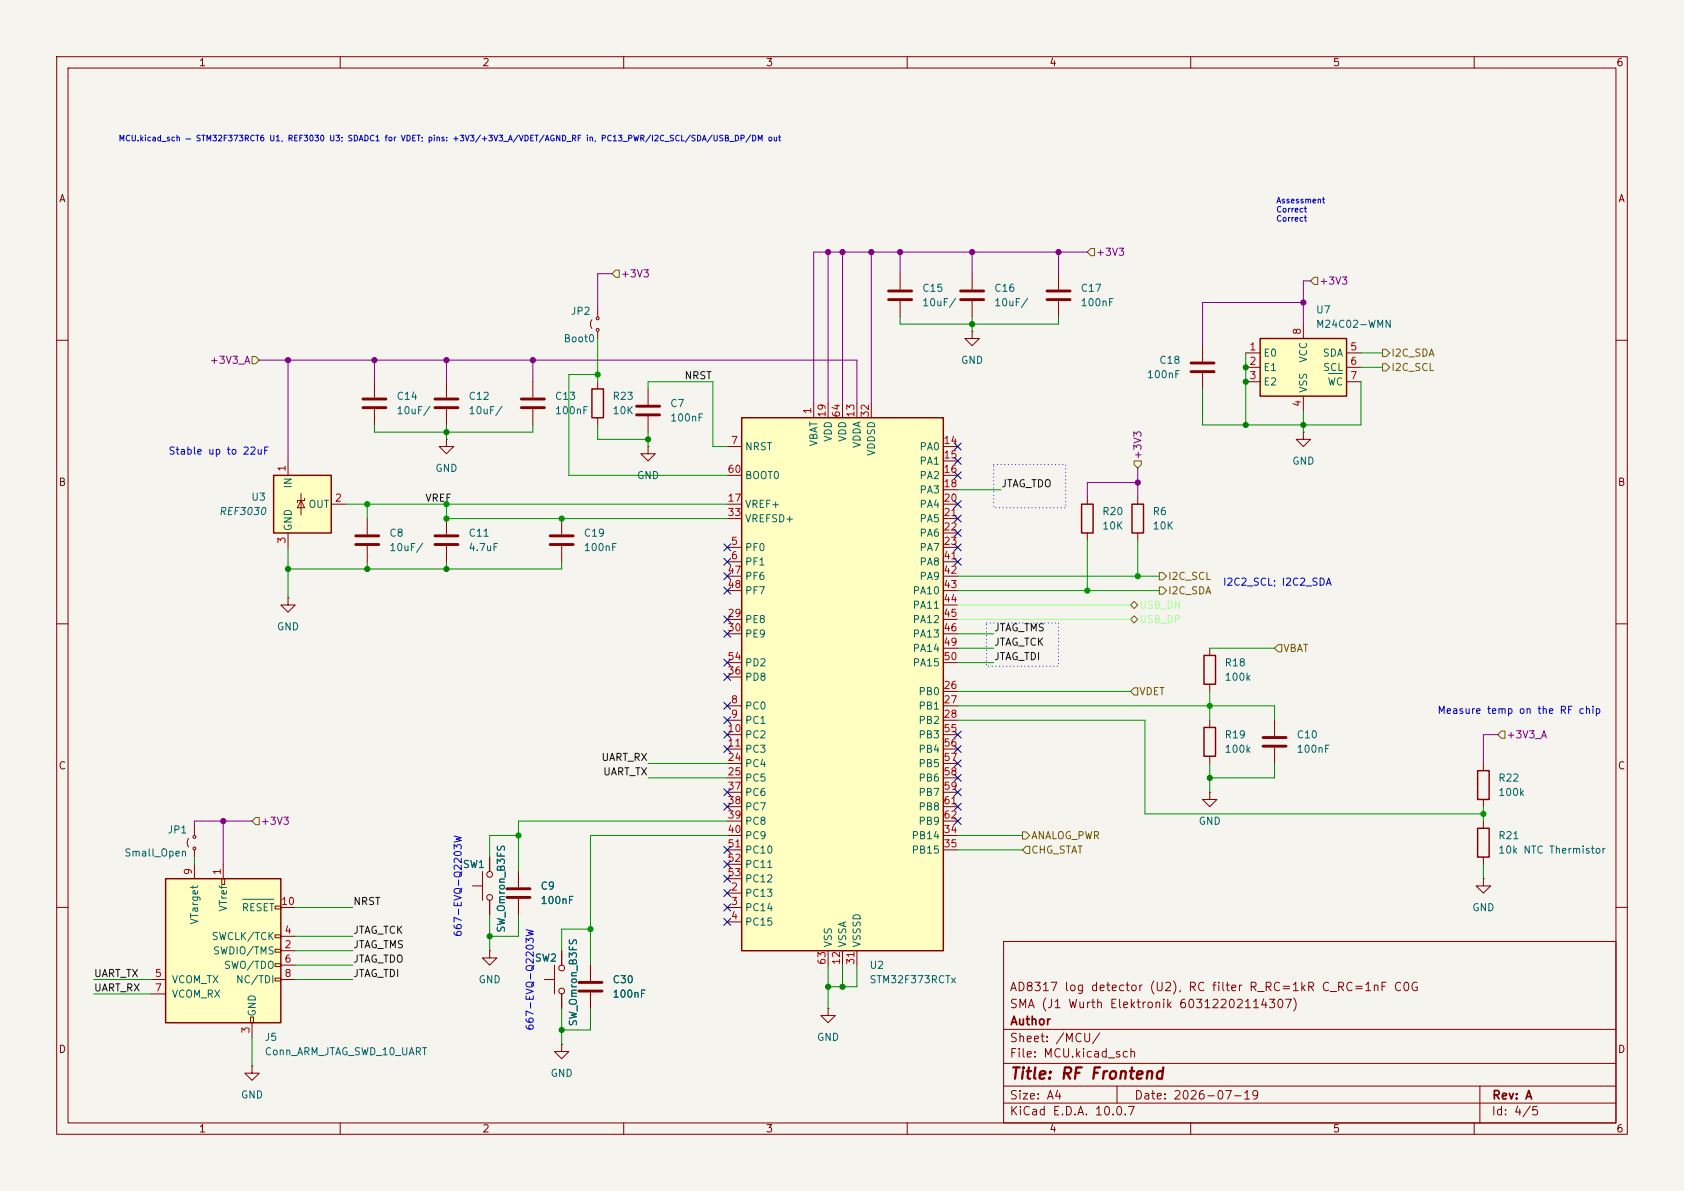
[picture p87: page 4]

Stable up to 22uF MCU.kicad_sch — STM32F373RCT6 U1, REF3030 U3; SDADC1 for VDET; pins: +3V3/+3V3_A/VDET/AGND_RF in, PC13_PWR/I2C_SCL/SDA/USB_DP/DM out
100nF GND

Measure temp on the RF chip

AD8317 log detector (U2), RC filter R_RC=1kR C_RC=1nF C0G
SMA (J1 Wurth Elektronik 60312202114307)
Author
Sheet: /MCU/
File: MCU.kicad_sch
Title: RF Frontend

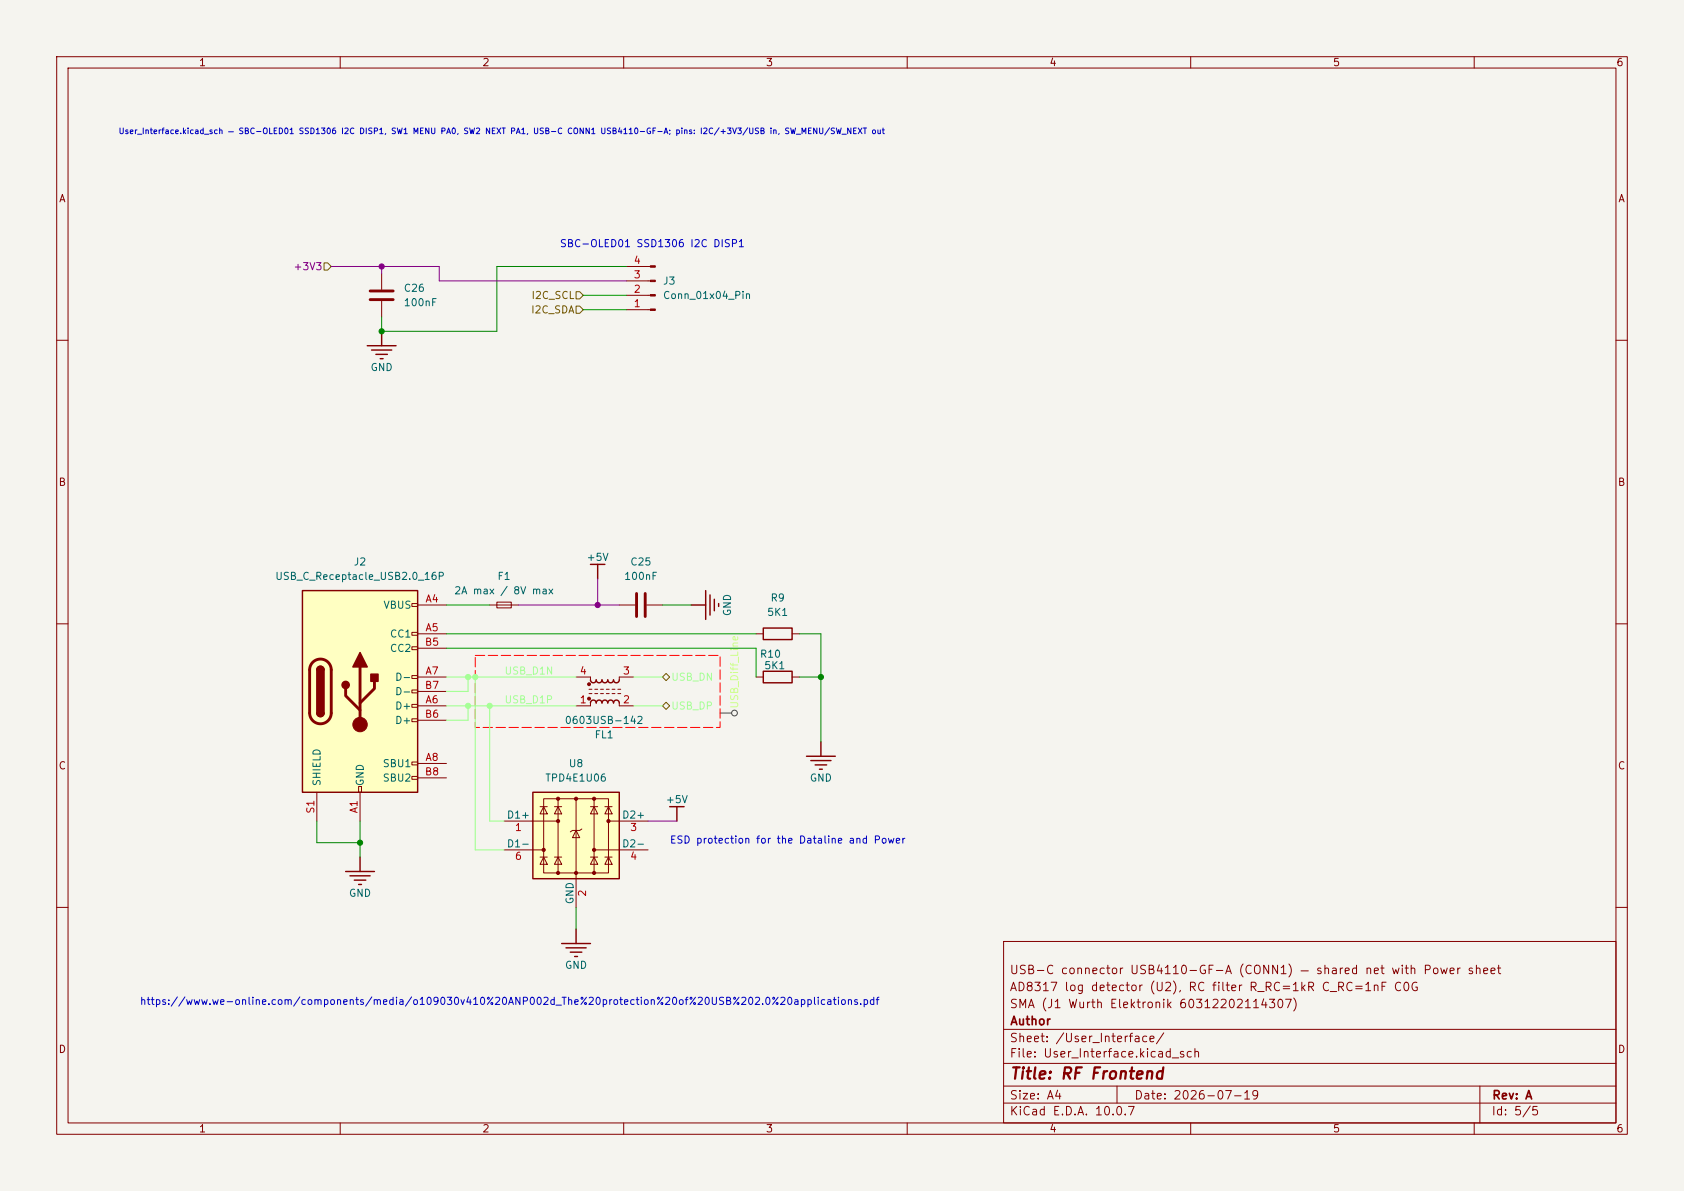
[picture p88: page 5]

User_Interface.kicad_sch — SBC-OLED01 SSD1306 I2C DISP1, SW1 MENU PA0, SW2 NEXT PA1, USB-C CONN1 USB4110-GF-A; pins: I2C/+3V3/USB in, SW_MENU/SW_NEXT out

USB-C connector USB4110-GF-A (CONN1) — shared net with Power sheet GND

SBU2 | B8 SHIELD S1

ESD protection for the Dataline and Power https://www.we-online.com/components/media/o109030v410%20ANP002d_The%20protection%20of%20USB%202.0%20applications.pdf

AD8317 log detector (U2), RC filter R_RC=1kR C_RC=1nF C0G
SMA (J1 Wurth Elektronik 60312202114307)
Author
Sheet: /User_Interface/
File: User_Interface.kicad_sch
Title: RF Frontend
