RolandWa/ad8317_powermeter/kicad/jlcpcb/production_files/pcb_layers/ad8317_powermeter-CuIn2.pdf

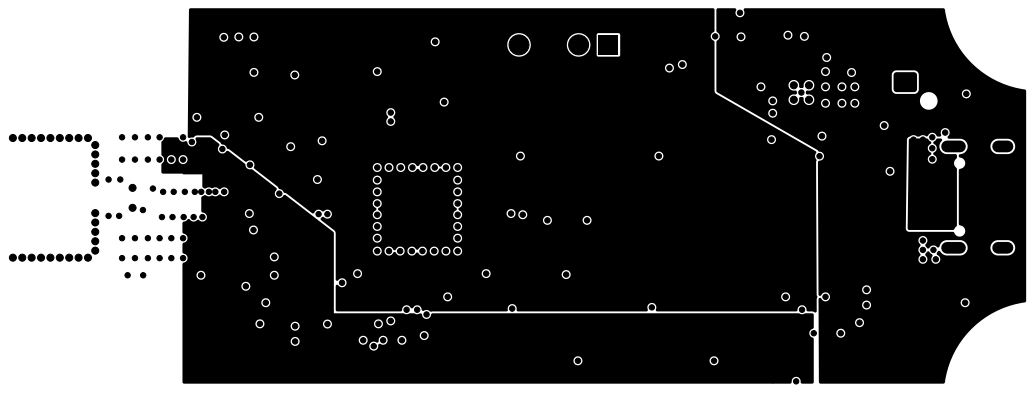
[picture p91: page 1]

Size: A4 | Rev: A
KiCad E.D.A. 10.0.7 | Id: /1
