RolandWa/ad8317_powermeter/kicad/jlcpcb/production_files/pcb_layers/ad8317_powermeter-SilkTop.pdf

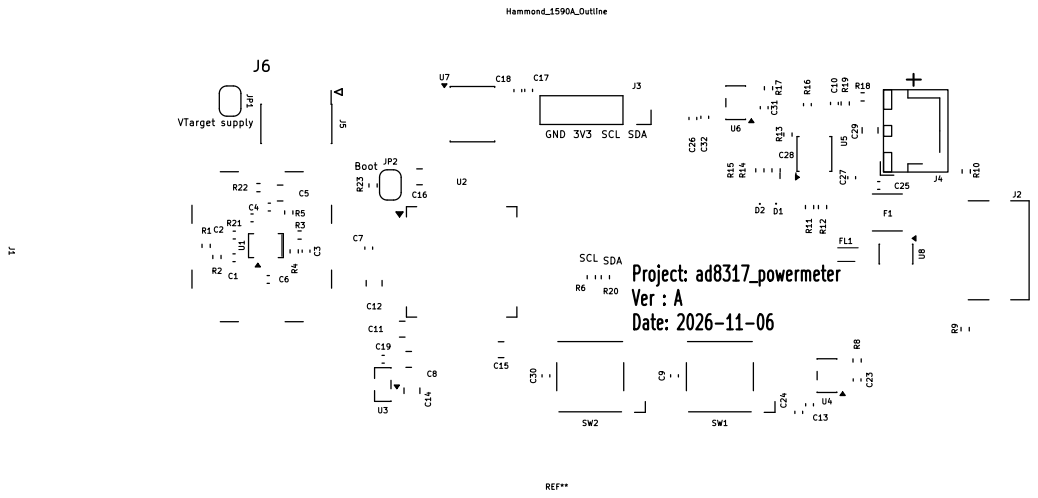
[picture p98: page 1]

SCL SCL SDA SDA Project: ad8317_powermeter

Size: A4 | Rev: A
KiCad E.D.A. 10.0.7 | Id: /1
