RolandWa/ad8317_powermeter/doc/132372.pdf

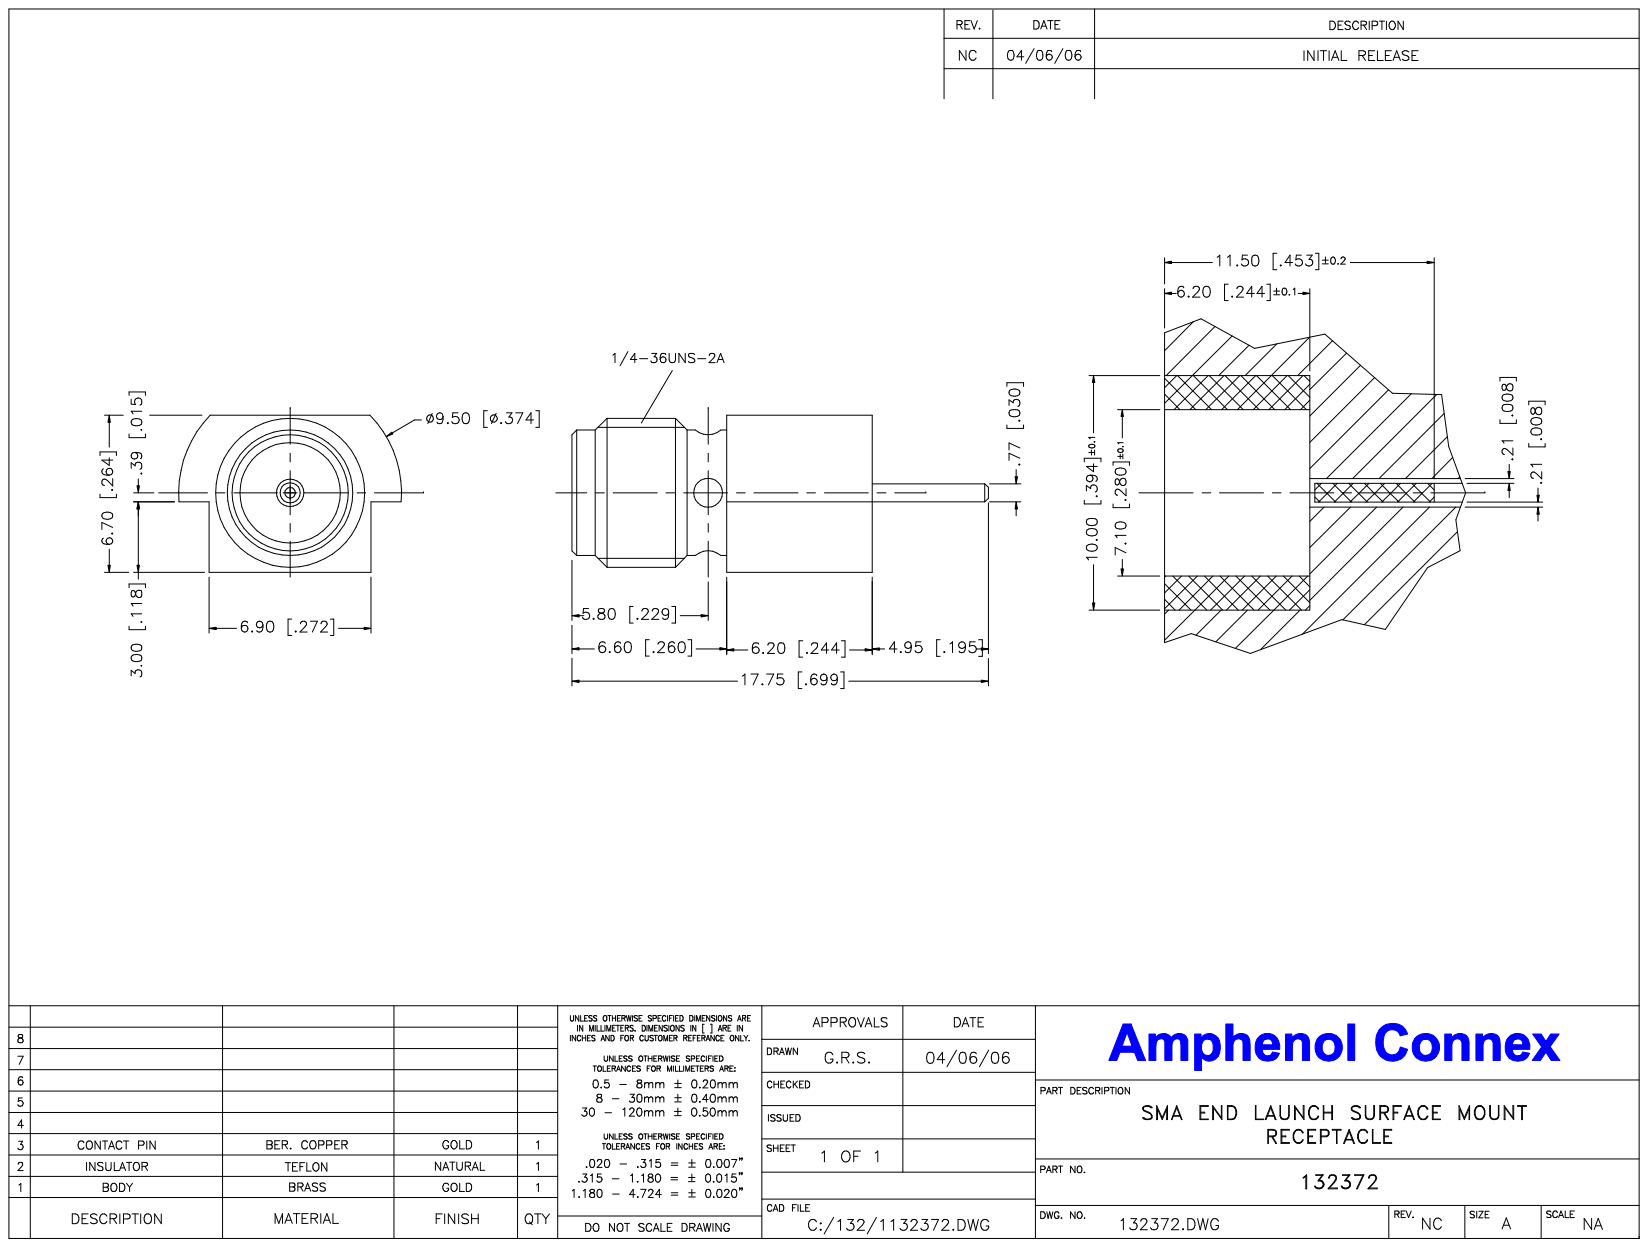
[picture p99: page 1]
