RolandWa/ad8317_powermeter/kicad/ad8317_powermeter.kicad_pcb

## KiCad design kicad/ad8317_powermeter.kicad_pcb (2026-11-13)

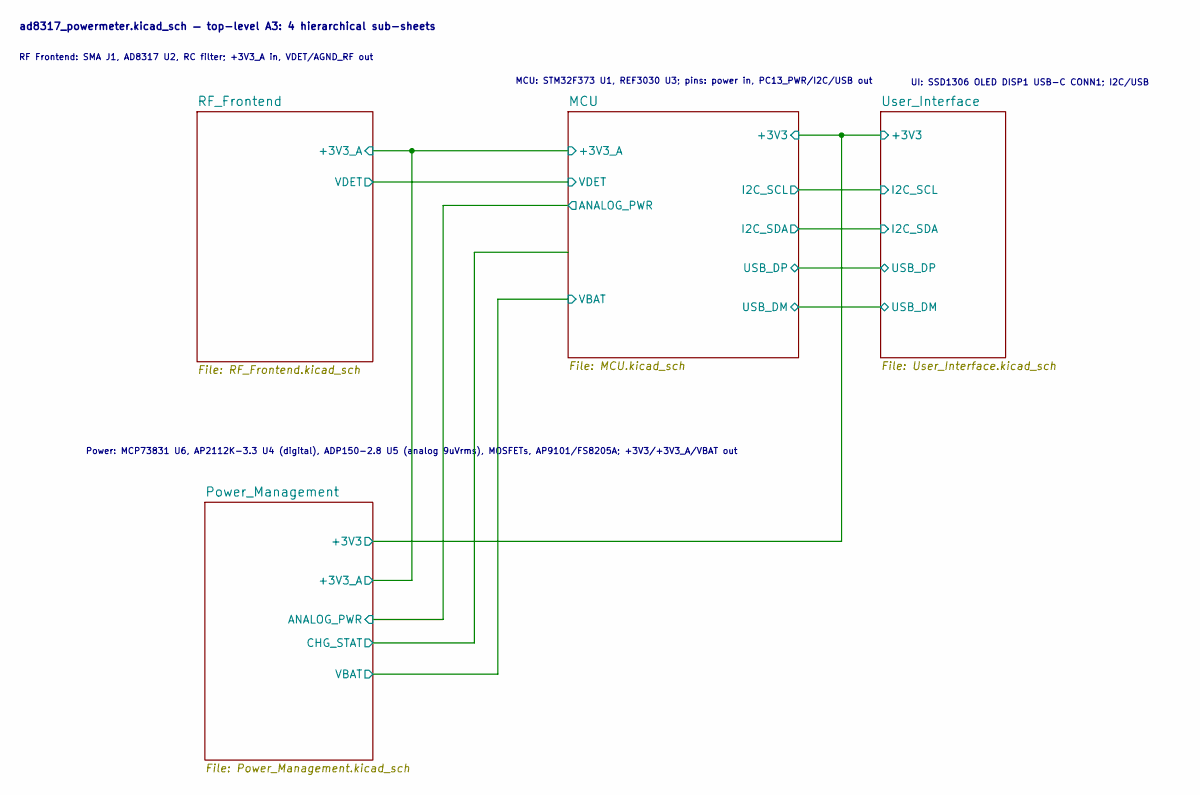
[picture p100: schematic ad8317_powermeter.kicad_sch, RF Frontend]

Notes on the sheet:
UI: SSD1306 OLED DISP1 USB-C CONN1; I2C/USB
MCU: STM32F373 U1, REF3030 U3; pins: power in, PC13_PWR/I2C/USB out
RF Frontend: SMA J1, AD8317 U2, RC filter; +3V3_A in, VDET/AGND_RF out
Power: MCP73831 U6, AP2112K-3.3 U4 (digital), ADP150-2.8 U5 (analog 9uVrms), MOSFETs, AP9101/FS8205A; +3V3/+3V3_A/VBAT out
ad8317_powermeter.kicad_sch — top-level A3: 4 hierarchical sub-sheets

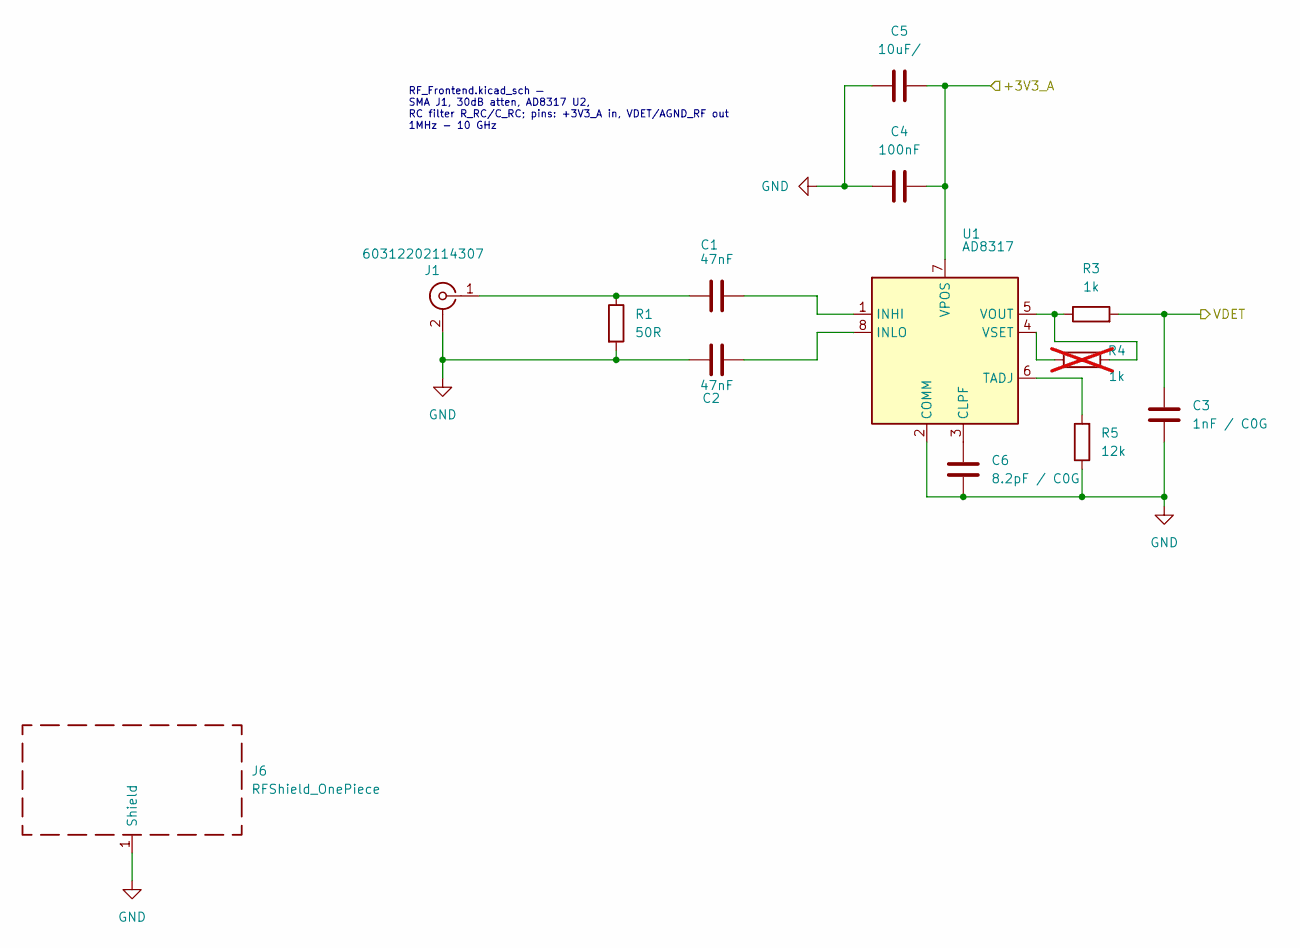
[picture p101: schematic RF_Frontend.kicad_sch, RF Frontend]

Parts:
C1, C2: 47nF; C_0402_1005Metric
C3: 1nF / C0G; C_0402_1005Metric
C4: 100nF; C_0402_1005Metric; LCSC C9900014224
C5: 10uF/; C_0805_2012Metric
C6: 8.2pF / C0G; C_0402_1005Metric
J1: 60312202114307; J_Wurth_WR-SMA_60312202114307; Part Number 60312202114307
J6: RFShield_OnePiece; Wuerth_36103305_30x30mm
R1: 50R; R_0402_1005Metric
R3: 1k; R_0402_1005Metric; LCSC C9900199398
R4: 1k; R_0402_1005Metric; not fitted
R5: 12k; R_0402_1005Metric
U1: AD8317; LFCSP-8-1EP_2x3mm_P0.5mm_EP1.6x2.34mm; MPN AD8317ACPZ-REEL7

Connections:
/MCU/+3V3_A: C4.2, C5.2, U1.7 (VPOS); also elsewhere on the board
/MCU/VDET: C3.2, R3.2; also elsewhere on the board
GND: C2.1, C3.1, C4.1, C5.1, C6.1, J1.2 (Ext), J6.1 (Shield_1), R1.2, R5.1, U1.2 (COMM), U1.9; also elsewhere on the board
unnamed: C1.1, J1.1 (In), R1.1
unnamed: C6.2, U1.3 (CLPF)
unnamed: C1.2, U1.1 (INHI)
unnamed: C2.2, U1.8 (INLO)
unnamed: R5.2, U1.6 (TADJ)
unnamed: R3.1, R4.2, U1.5 (VOUT)
unnamed: R4.1, U1.4 (VSET)

Notes on the sheet:
RF_Frontend.kicad_sch — SMA J1, 30dB atten, AD8317 U2, RC filter R_RC/C_RC; pins: +3V3_A in, VDET/AGND_RF out 1MHz - 10 GHz

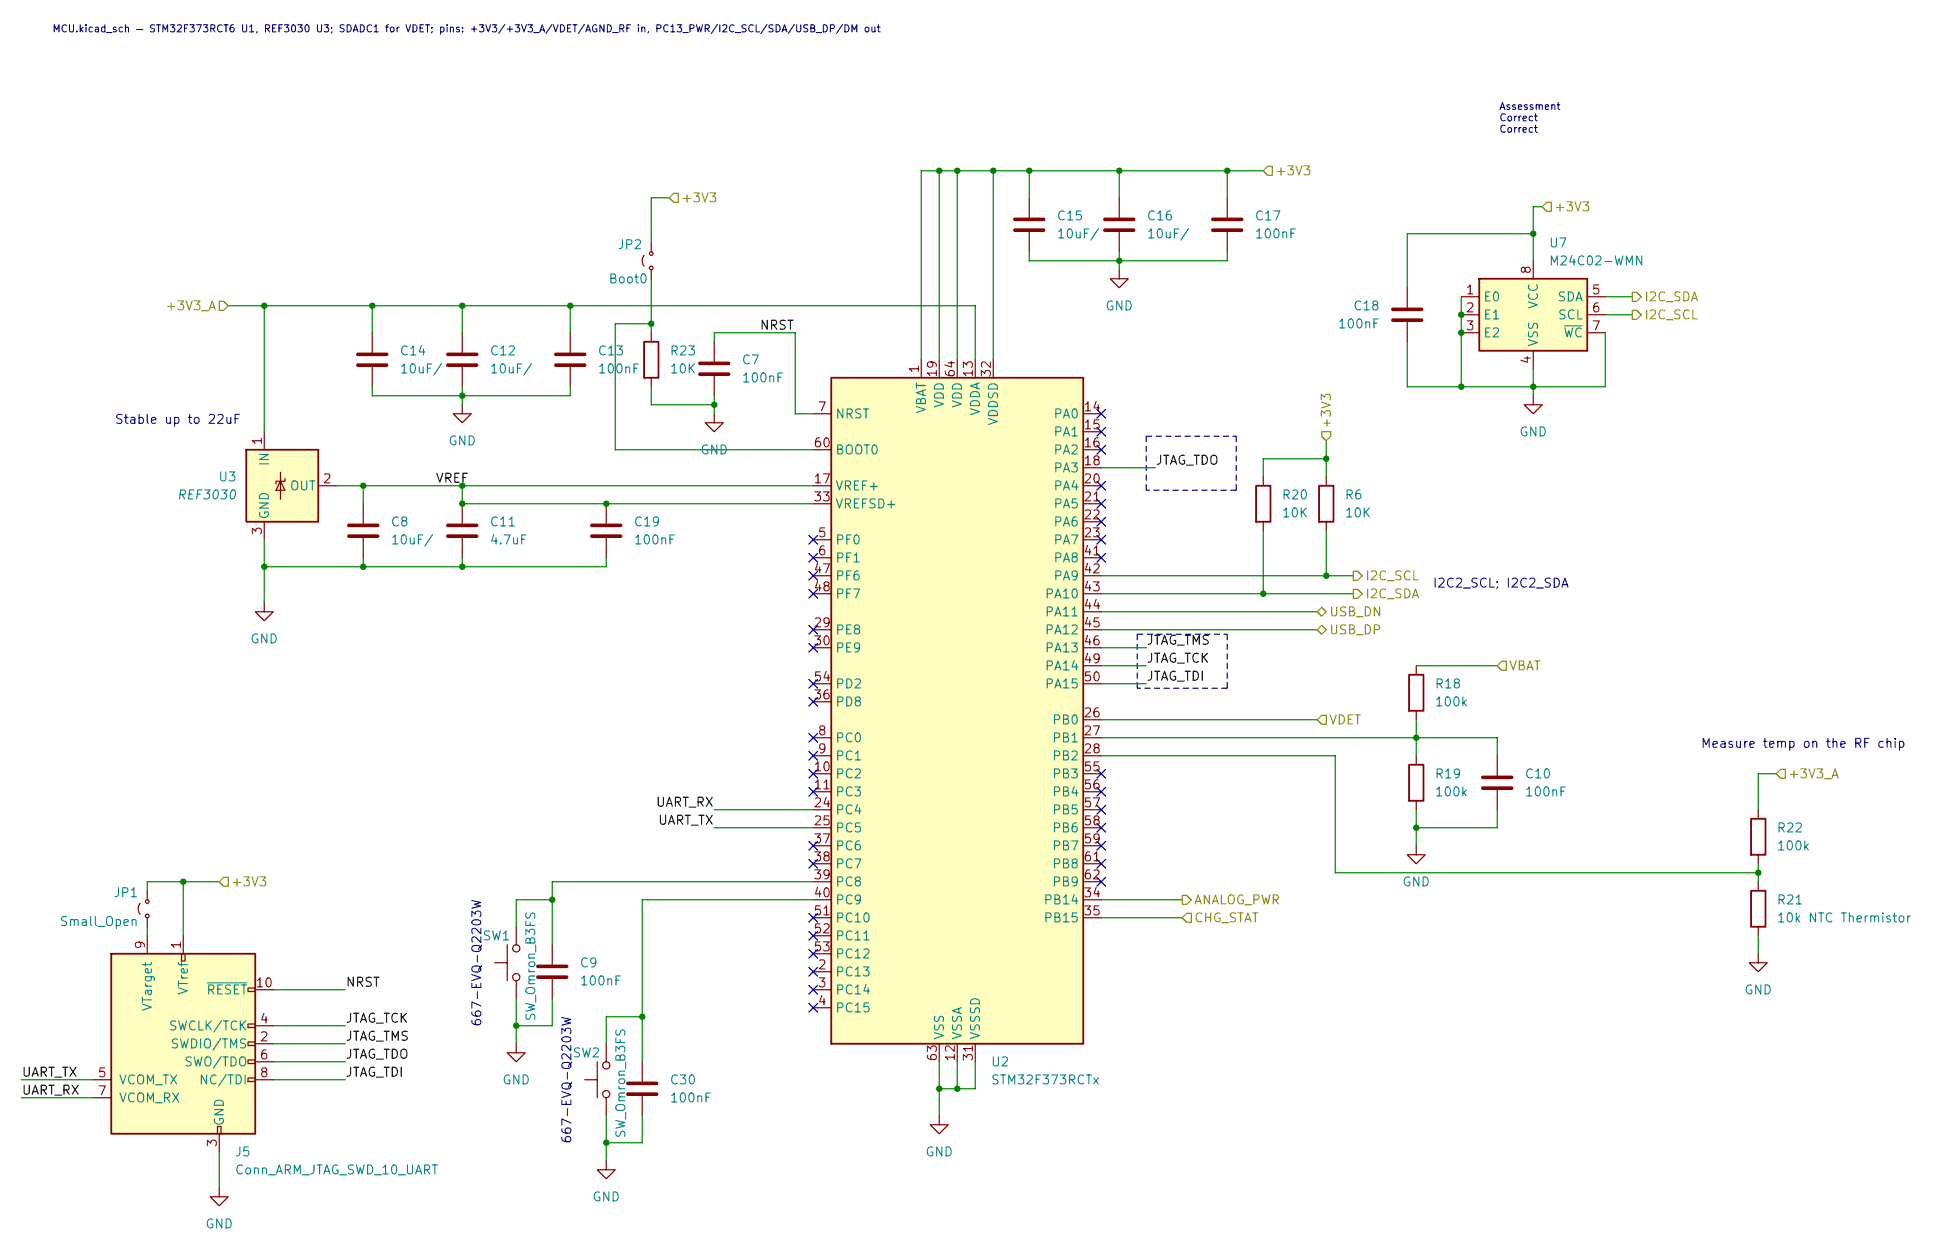
[picture p102: schematic MCU.kicad_sch, RF Frontend]

Parts:
C7, C9, C10, C13, C17, C18, C19, C30: 100nF; C_0402_1005Metric; LCSC C9900014224
C8, C12, C14, C15, C16: 10uF/; C_0805_2012Metric
C11: 4.7uF; C_0805_2012Metric
J5: Conn_ARM_JTAG_SWD_10_UART; PinHeader_2x05_P1.27mm_Vertical_SMD
JP1: Small_Open; SolderJumper-2_P1.3mm_Open_RoundedPad1.0x1.5mm
JP2: Boot0; SolderJumper-2_P1.3mm_Open_RoundedPad1.0x1.5mm
R6, R20, R23: 10K; R_0402_1005Metric
R18, R19, R22: 100k; R_0402_1005Metric
R21: 10k NTC Thermistor; C_0402_1005Metric; LCSC C2892547
SW1, SW2: SW_Omron_B3FS; SW_SPST_Omron_B3FS-100xP
U2: STM32F373RCTx; LQFP-64_10x10mm_P0.5mm
U3: REF3030; SOT-23
U7: M24C02-WMN; SOIC-8_3.9x4.9mm_P1.27mm

Connections:
/MCU/+3V3: C15.2, C16.2, C17.2, C18.1, J5.1 (VTref), JP1.2 (B), JP2.2 (B), R6.1, R20.1, U2.1 (VBAT), U2.19 (VDD), U2.32 (VDDSD), U2.64 (VDD), U7.8 (VCC); also elsewhere on the board
/MCU/+3V3_A: C12.2, C13.2, C14.2, R22.1, U2.13 (VDDA), U3.1 (IN); also elsewhere on the board
/MCU/ANALOG_PWR: U2.34 (PB14); also elsewhere on the board
/MCU/CHG_STAT: U2.35 (PB15); also elsewhere on the board
/MCU/I2C_SCL: R6.2, U2.42 (PA9), U7.6 (SCL); also elsewhere on the board
/MCU/I2C_SDA: R20.2, U2.43 (PA10), U7.5 (SDA); also elsewhere on the board
/MCU/JTAG_TCK: J5.4 (SWCLK/TCK), U2.49 (PA14)
/MCU/JTAG_TDI: J5.8 (NC/TDI), U2.50 (PA15)
/MCU/JTAG_TDO: J5.6 (SWO/TDO), U2.18 (PA3)
/MCU/JTAG_TMS: J5.2 (SWDIO/TMS), U2.46 (PA13)
/MCU/NRST: C7.2, J5.10 (~RESET), U2.7 (NRST)
/MCU/UART_RX: J5.7 (VCOM_RX), U2.24 (PC4)
/MCU/UART_TX: J5.5 (VCOM_TX), U2.25 (PC5)
/MCU/USB_DN: U2.44 (PA11); also elsewhere on the board
/MCU/USB_DP: U2.45 (PA12); also elsewhere on the board
/MCU/VBAT: R18.1; also elsewhere on the board
/MCU/VDET: U2.26 (PB0); also elsewhere on the board
/MCU/VREF: C8.2, C11.2, C19.2, U2.17 (VREF+), U2.33 (VREFSD+), U3.2 (OUT)
GND: C7.1, C8.1, C9.1, C10.1, C11.1, C12.1, C13.1, C14.1, C15.1, C16.1, C17.1, C18.2, C19.1, C30.1, J5.3 (GND), R19.2, R21.1, R23.2, SW1.1, SW2.1, U2.12 (VSSA), U2.31 (VSSSD), U2.63 (VSS), U3.3 (GND), U7.1 (E0), U7.2 (E1), U7.3 (E2), U7.4 (VSS), U7.7 (~WC); also elsewhere on the board
unnamed: J5.9 (VTarget), JP1.1 (A)
unnamed: JP2.1 (A), R23.1, U2.60 (BOOT0)
unnamed: C10.2, R18.2, R19.1, U2.27 (PB1)
unnamed: R21.2, R22.2, U2.28 (PB2)
unnamed: C9.2, SW1.2, U2.39 (PC8)
unnamed: C30.2, SW2.2, U2.40 (PC9)

Notes on the sheet:
Assessment Correct Correct
667-EVQ-Q2203W
Stable up to 22uF
Measure temp on the RF chip
MCU.kicad_sch — STM32F373RCT6 U1, REF3030 U3; SDADC1 for VDET; pins: +3V3/+3V3_A/VDET/AGND_RF in, PC13_PWR/I2C_SCL/SDA/USB_DP/DM out
I2C2_SCL; I2C2_SDA

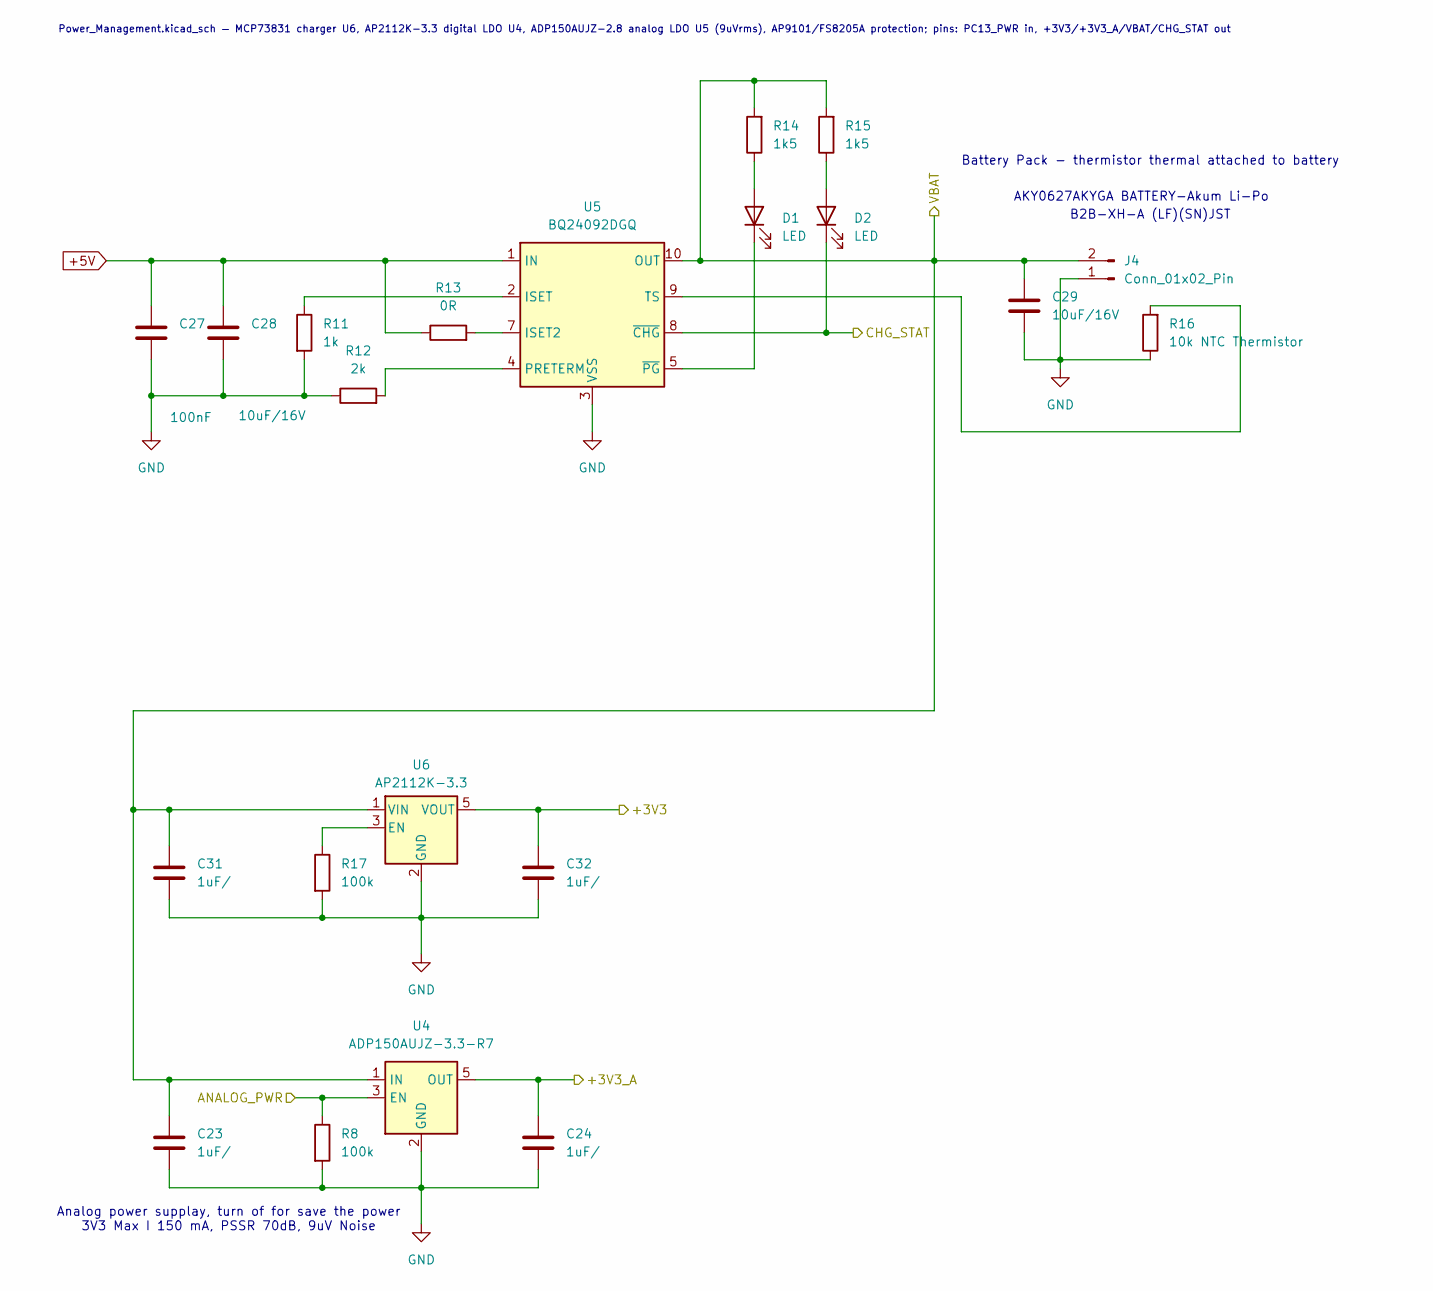
[picture p103: schematic Power_Management.kicad_sch, RF Frontend]

Parts:
C23, C24, C31, C32: 1uF/; C_0402_1005Metric
C27: 100nF; C_0402_1005Metric; LCSC C9900014224
C28, C29: 10uF/16V; C_0805_2012Metric; LCSC C9900019493
D1, D2: LED; LED_0402_1005Metric; LCSC C9900022508
J4: Conn_01x02_Pin; JST_XH_B2B-XH-AM_1x02_P2.50mm_Vertical; LCSC C161869
R8, R17: 100k; R_0402_1005Metric
R11: 1k; R_0402_1005Metric; LCSC C9900199398
R12: 2k; R_0402_1005Metric; LCSC C140225
R13: 0R; R_0402_1005Metric; LCSC C140225
R14, R15: 1k5; R_0402_1005Metric; LCSC C269672
R16: 10k NTC Thermistor; C_0402_1005Metric; LCSC C2892547
U4: ADP150AUJZ-3.3-R7; TSOT-23-5
U5: BQ24092DGQ; HVSSOP-10-1EP_3x3mm_P0.5mm_EP1.83x1.89mm_ThermalVias; Digikey BQ24092DGQT
U6: AP2112K-3.3; SOT-23-5

Connections:
+5V: C27.1, C28.1, R13.1, U5.1 (IN); also elsewhere on the board
/MCU/+3V3: C32.2, U6.5 (VOUT); also elsewhere on the board
/MCU/+3V3_A: C24.2, U4.5 (OUT); also elsewhere on the board
/MCU/ANALOG_PWR: R8.1, U4.3 (EN); also elsewhere on the board
/MCU/CHG_STAT: D2.1 (K), U5.8 (~CHG); also elsewhere on the board
/MCU/VBAT: C23.2, C29.1, C31.2, J4.2, R14.2, R15.2, U4.1 (IN), U5.10 (OUT), U6.1 (VIN); also elsewhere on the board
GND: C23.1, C24.1, C27.2, C28.2, C29.2, C31.1, C32.1, J4.1, R8.2, R11.2, R12.1, R16.1, R17.2, U4.2 (GND), U5.3 (VSS), U5.11 (VSS), U6.2 (GND); also elsewhere on the board
unnamed: D1.2 (A), R14.1
unnamed: D1.1 (K), U5.5 (~PG)
unnamed: D2.2 (A), R15.1
unnamed: R13.2, U5.7 (ISET2)
unnamed: R11.1, U5.2 (ISET)
unnamed: R12.2, U5.4 (PRETERM)
unnamed: R16.2, U5.9 (TS)
unnamed: R17.1, U6.3 (EN)

Notes on the sheet:
Battery Pack - thermistor thermal attached to battery
B2B-XH-A (LF)(SN)JST
Power_Management.kicad_sch — MCP73831 charger U6, AP2112K-3.3 digital LDO U4, ADP150AUJZ-2.8 analog LDO U5 (9uVrms), AP9101/FS8205A protection; pins: PC13_PWR in, +3V3/+3V3_A/VBAT/CHG_STAT out
AKY0627AKYGA BATTERY-Akum Li-Po
Analog power supplay, turn of for save the power 3V3 Max I 150 mA, PSSR 70dB, 9uV Noise

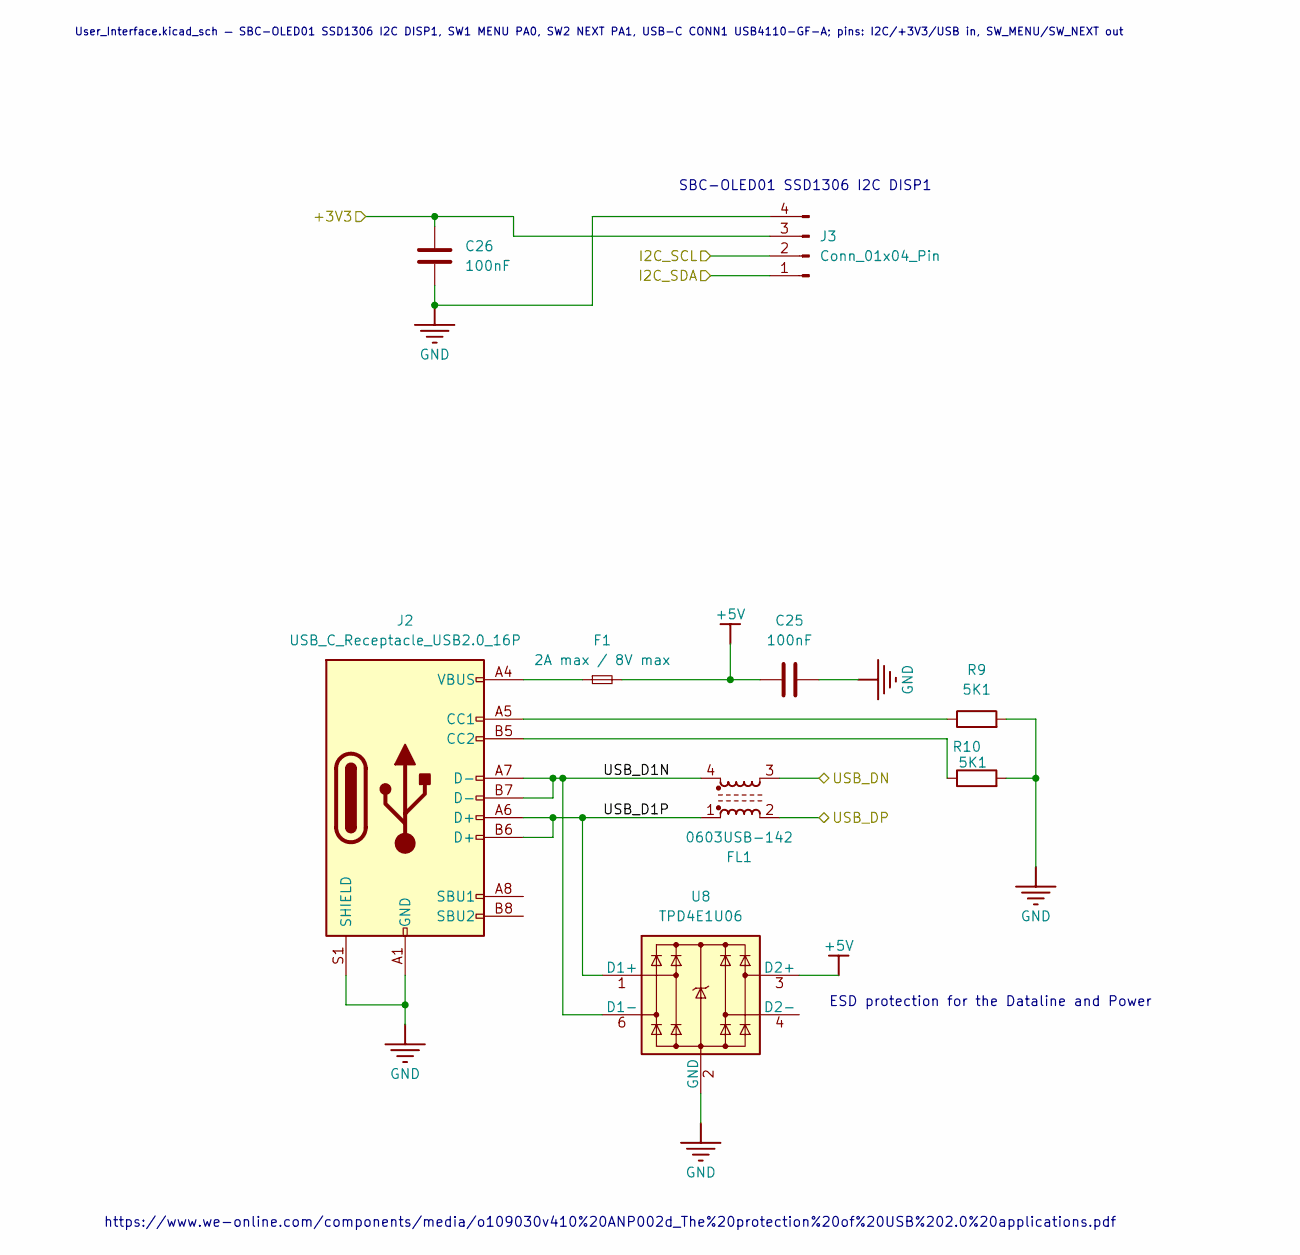
[picture p104: schematic User_Interface.kicad_sch, RF Frontend]

Parts:
C25, C26: 100nF; C_0402_1005Metric; LCSC C9900014224
F1: 2A max / 8V max; Fuse_1812_4532Metric_Pad1.30x3.40mm_HandSolder
FL1: 0603USB-142; L_CommonModeChoke_Coilcraft_0603USB
J2: USB_C_Receptacle_USB2.0_16P; USB_C_Receptacle_G-Switch_GT-USB-7010ASV
J3: Conn_01x04_Pin; PinHeader_1x04_P2.54mm_Vertical
R9, R10: 5K1; R_0402_1005Metric_Pad0.72x0.64mm_HandSolder; LCSC C5913162
U8: TPD4E1U06; SOT-23-6

Connections:
+5V: C25.2, F1.2, U8.3 (D2+); also elsewhere on the board
/MCU/+3V3: C26.2, J3.3; also elsewhere on the board
/MCU/I2C_SCL: J3.2; also elsewhere on the board
/MCU/I2C_SDA: J3.1; also elsewhere on the board
/MCU/USB_DN: FL1.3; also elsewhere on the board
/MCU/USB_DP: FL1.2; also elsewhere on the board
/User_Interface/USB_D1N: FL1.4, J2.A7 (D-), J2.B7 (D-), U8.6 (D1-)
/User_Interface/USB_D1P: FL1.1, J2.A6 (D+), J2.B6 (D+), U8.1 (D1+)
GND: C25.1, C26.1, J2.A1 (GND), J2.A12 (GND), J2.B1 (GND), J2.B12 (GND), J2.S1 (SHIELD), J3.4, R9.2, R10.2, U8.2 (GND); also elsewhere on the board
unnamed: F1.1, J2.A4 (VBUS), J2.A9 (VBUS), J2.B4 (VBUS), J2.B9 (VBUS)
unnamed: J2.A5 (CC1), R9.1
unnamed: J2.B5 (CC2), R10.1

Notes on the sheet:
ESD protection for the Dataline and Power
SBC-OLED01 SSD1306 I2C DISP1
https://www.we-online.com/components/media/o109030v410%20ANP002d_The%20protection%20of%20USB%202.0%20applications.pdf
User_Interface.kicad_sch — SBC-OLED01 SSD1306 I2C DISP1, SW1 MENU PA0, SW2 NEXT PA1, USB-C CONN1 USB4110-GF-A; pins: I2C/+3V3/USB in, SW_MENU/SW_NEXT out

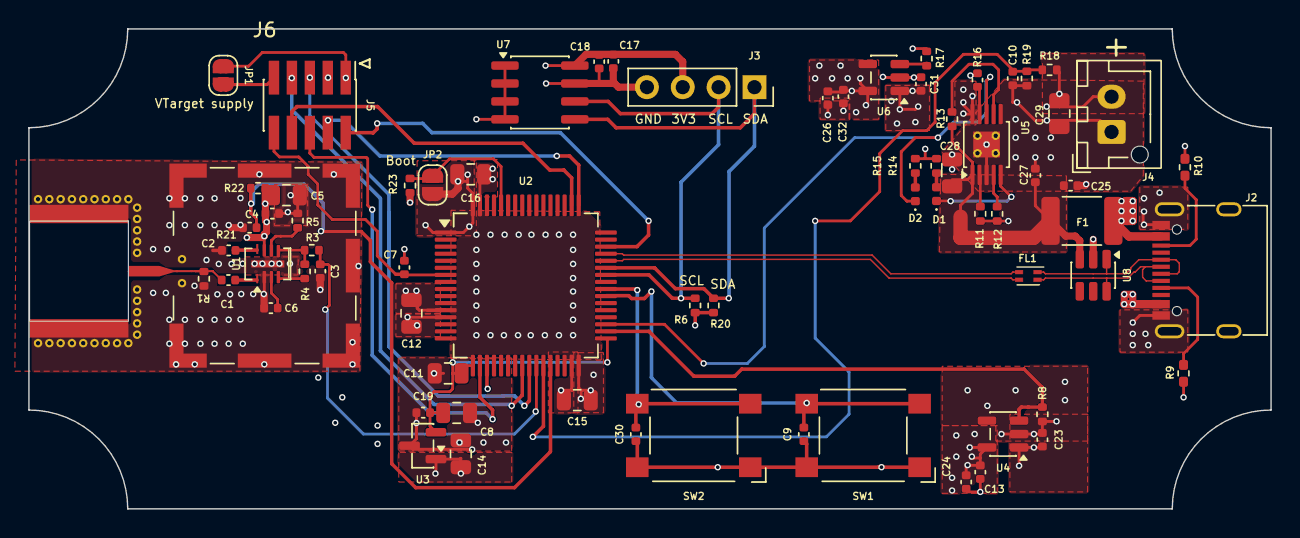
[picture p105: board ad8317_powermeter.kicad_pcb from above]

Board: 4 copper layers, 88.0 x 34.0 mm, 72 parts (0 on the bottom side), 46 nets.
