RolandWa/ad8317_powermeter/tests/Power_Meter_Validation_Suite.py

#!/usr/bin/env python3
"""
Project: Handheld Micro-RF Power Meter Validation Suite
Target Devices: Keysight U2000A / Rohde & Schwarz NRP-Z21 Emulation Modes
Description: Production-grade integration test suite to validate SCPI command 
             parsers, emulated USB profiles, and metrological performance.
Toolchain: Python 3.x with PyVISA and PySerial
"""

import time
import unittest
import serial
from serial.tools import list_ports

# =====================================================================
# 1. HARDWARE LAYER CONFIGURATION & SCANNING
# =====================================================================

class USBDeviceDescriptorScanner:
    """Scans and verifies native USB-OTG descriptors for emulation profiles."""
    
    KEYSIGHT_VID = 0x2A8D
    KEYSIGHT_PID = 0x7E18
    RS_VID = 0x0AAD
    RS_PID = 0x00A1

    @classmethod
    def scan_for_emulated_device(cls):
        """Scans system USB ports to verify VID/PID configurations."""
        ports = list_ports.comports()
        for port in ports:
            if port.vid == cls.KEYSIGHT_VID and port.pid == cls.KEYSIGHT_PID:
                return port.device, "KEYSIGHT"
            elif port.vid == cls.RS_VID and port.pid == cls.RS_PID:
                return port.device, "ROHDE_SCHWARZ"
        return None, "GENERIC_CDC"

# =====================================================================
# 2. SCPI CORE INTERFACE DRIVER
# =====================================================================

class MicroRFPowerMeterDriver:
    """Hardware abstraction interface handling connection, transaction isolation,

    and SCPI parsing validation.
    """
    def __init__(self, port, timeout=1.5):
        self.port = port
        self.timeout = timeout
        self.connection = None

    def connect(self):
        """Initializes raw serial link bypassing host OS echo dependencies."""
        self.connection = serial.Serial(
            port=self.port,
            baudrate=115200,
            bytesize=serial.EIGHTBITS,
            parity=serial.PARITY_NONE,
            stopbits=serial.STOPBITS_ONE,
            timeout=self.timeout,
            xonxoff=False,
            rtscts=False,
            dsrdtr=False
        )
        time.sleep(0.1)  # Settling delay for micro-OS ring buffers
        self.connection.reset_input_buffer()
        self.connection.reset_output_buffer()

    def disconnect(self):
        if self.connection and self.connection.is_open:
            self.connection.close()

    def write_cmd(self, command: str):
        """Dispatches standardized SCPI frames terminated with standard LF line feeds."""
        frame = f"{command}\n".encode('ascii')
        self.connection.write(frame)
        self.connection.flush()

    def query(self, command: str) -> str:
        """Executes full atomic write-read SCPI transaction."""
        self.write_cmd(command)
        response = self.connection.readline()
        return response.decode('ascii').strip()

# =====================================================================
# 3. AUTOMATED METROLOGY VALIDATION SUITE
# =====================================================================

class TestMicroRFPowerMeterSCPI(unittest.TestCase):
    """Execution grid validating functional correctness of firmware architectures."""
    
    @classmethod
    def setUpClass(cls):
        """Locates and locks the physical interface link before executing matrix."""
        cls.device_port, cls.active_profile = USBDeviceDescriptorScanner.scan_for_emulated_device()
        if not cls.device_port:
            raise unittest.SkipTest("Target physical meter not found. Connect device under test (DUT).")
        
        cls.driver = MicroRFPowerMeterDriver(cls.device_port)
        cls.driver.connect()

    @classmethod
    def tearDownClass(cls):
        cls.driver.disconnect()

    def setUp(self):
        """Enforces predictable meter state topology prior to every isolated query execution."""
        self.driver.query("*RST")

    def test_identity_descriptor_string(self):
        """Verifies SCPI structural parsing compliance of the mandatory identity query."""
        response = self.driver.query("*IDN?")
        self.assertIsNotNone(response)
        
        if self.active_profile == "KEYSIGHT":
            self.assertTrue(response.startswith("Keysight Technologies,U2000A"))
        elif self.active_profile == "ROHDE_SCHWARZ":
            self.assertTrue(response.startswith("Rohde&Schwarz,NRP-Z21"))
        else:
            self.assertIn("Mete", response or "DIY_Lab")

    def test_metrology_read_pipeline(self):
        """Forces hardware burst snapshots. Validates data formats and processing delays."""
        start_time = time.perf_counter()
        response = self.driver.query("READ?")
        end_time = time.perf_counter()
        
        # Ensure conversion, DMA burst window, and averaging routines fall under budget
        execution_latency_ms = (end_time - start_time) * 1000
        self.assertLess(execution_latency_ms, 150.0, "Metrological pipeline latency constraint breached.")
        
        # Verify strict scientific/floating numerical payload returned by driver
        try:
            power_dbm = float(response)
        except ValueError:
            self.fail(f"Non-conforming alphanumeric data streamed back to host: {response}")
            
        # Ensure payload boundaries are reasonable for an active or unconnected AD8317 sensor
        self.assertTrue(-65.0 <= power_dbm <= 35.0, f"Abnormal power reading returned: {power_dbm} dBm")

    def test_dynamic_offset_calibration_shifting(self):
        """Validates real-time external calibration array recalculations within firmware."""
        # Baseline attenuation configuration update
        status_check = self.driver.query("CALC:GAIN -30.0")
        self.assertEqual(status_check, "OK", "Firmware failed to register system variable change.")
        
        # Snapshot post-calibration power reading
        attenuated_reading = float(self.driver.query("READ?"))
        
        # Reset device parameter definitions via SCPI
        self.driver.query("*RST")
        unattenuated_reading = float(self.driver.query("READ?"))
        
        # The delta should tightly bound our injected 30.0 dB hardware parameter shift
        delta_shift = attenuated_reading - unattenuated_reading
        self.assertAlmostEqual(delta_shift, 30.0, delta=1.5, msg="Calibration index shift error.")

    def test_frequency_lookup_indexing(self):
        """Ensures index boundaries map reliably to localized calibration matrices."""
        freq_set_2g4 = self.driver.query("SENS:FREQ 2400000000")
        self.assertEqual(freq_set_2g4, "OK", "2.4GHz calibration curve setting failed.")
        reading_2g4 = float(self.driver.query("READ?"))

        freq_set_5g8 = self.driver.query("SENS:FREQ 5800000000")
        self.assertEqual(freq_set_5g8, "OK", "5.8GHz calibration curve setting failed.")
        reading_5g8 = float(self.driver.query("READ?"))
        
        # Sensor response changes with frequency; readings should reflect the lookup tables
        self.assertNotEqual(reading_2g4, reading_5g8, "Firmware failed to cycle calibration lookups.")

    def test_inactivity_watchdog_isolation(self):
        """Forces deep sleep verification routines."""
        # Custom timeout injection test configuration if supported by firmware
        self.driver.write_cmd("SYST:SLEEP") # Optional forcing string instruction 
        time.sleep(0.5) # Allow transition sequence execution
        
        # Attempt data execution pipeline recovery across isolated rail
        try:
            wake_check = self.driver.query("*IDN?")
            self.assertTrue(len(wake_check) > 0)
        except serial.SerialException:
            self.fail("Device crashed or dropped off USB bus during power transition.")

# =====================================================================
# 4. ENTRY INTERFACE EXTRACTION
# =====================================================================

if __name__ == "__main__":
    print("[INFO] Initializing Handheld Micro-RF Power Meter Integration Test Framework...")
    device_port, detected_profile = USBDeviceDescriptorScanner.scan_for_emulated_device()
    print(f"[INFO] Target Port Mapping Detected: {device_port} | Profile Mapping Locked: {detected_profile}")
    
    # Run the test matrix
    unittest.main()
