RolandWa/ad8317_powermeter/(commit log)

2026-07-21 Initial commit: KiCad PCB design + EMerge FEM simulation pipeline
    - KiCad schematics and PCB layout for AD8317 handheld RF power meter
    - Component library: SMA connectors, custom AD8317 symbol, 3D models
    - EMerge FEM plugin v1.2.0: KiCad action plugin + system Python subprocess bridge
    - FileBasedPCB (Gerber) and PCBNew geometry backends (use_gerbers flag)
    - Passive R/L/C lumped element modelling from PCB footprints
    - Board outline detection with largest-area polygon selection
    - python_bridge.py: auto-discovers system Python with EMerge installed
    - Explicit python_exe override in emerge_config.toml
    - Per-step timing, geometry viewer, debug snapshot (PNG/STEP)
    - Test suite: 121 tes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
    [MCU.kicad_sch, Power_Management.kicad_sch, RF_Frontend.kicad_sch, User_Interface.kicad_sch, ad8317_powermeter.kicad_pcb, ad8317_powermeter.kicad_sch]
2026-07-21 Add detailed debug output to Gerber export and model builder
    gerber_exporter: show PCB file size, full kicad-cli command, each
    exported file with size, kicad-cli stdout/stderr in debug mode.
    emerge_runner: show board size, simulation domain size and margin,
    per-port domain check (warns when a port lies outside the simulation
    boundary), Gerber file sizes before loading, "parsing ..." banner so
    the 4-min F.Cu load is visible, Gerber directory listing in debug mode.
2026-07-21 Fix simulation domain and port naming
    Domain: always expand to include all ports even when placed outside
    the Edge.Cuts board outline (handles IC placed off-board in KiCad).
    Each expansion is logged with before/after coordinates.
    Ports: probe lumped_port_pts() signature before passing name=; try
    setting name attr on the returned geometry object so the EMerge viewer
    shows "PORT1"/"PORT2" instead of auto-generated "name_0"/"name_1".
    Also log p1/p2 corner coordinates for each port for verification.
2026-07-22 Refactor EMerge pipeline: gerber_builder, passive_modeler, mesh robustness
    Split emerge_runner.py into three modules:
    - gerber_builder.py: Gerber loading, 3D geometry build, commit, sliver fix,
    GMSH viewers, save_geometry_debug
    - passive_modeler.py: SPICE netlist parser, R/L/C element placement
    - emerge_runner.py: orchestrator only (stages 1-5)
    Mesh robustness fixes for complex PCBs with copper pours:
    - Detect shortest boundary curve on large (>1 mm) surfaces; set
    Mesh.CharacteristicLengthMax = 80 % of that length so CDT triangles near
    tiny thermal-relief / clearance curves are fine enough for edge recovery
    - Sliver surface fix: setTransfiniteCurve(n) on all 190 OCC boolean artefact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
2026-08-02 Add calibration scripts, documentation, simulation tools, and KiCad updates
    - cal/calibration.py: 3-phase RF linearity calibration (29 freq, 28 power steps,
    1 MHz–10 GHz, direct generator→DUT, no attenuator, NRP sensor 0.01 dBm precision)
    - cal/temp_calibration.py: temperature calibration via Vötsch chamber (16–40°C,
    Vötsch SIMSERV TCP driver, tracking generator source, outputs TEMP_COEFF_DB_PER_C[])
    - cal/results/: dry-run calibration tables (.h/.json), figures, PDF reports
    - doc/: ADC signal path analysis, calibration procedure (3-phase), lab optimisation
    guide updated for 1 MHz–10 GHz range and temperature correction firmware formula
    - doc/diagrams/: PlantUML/Mermaid sour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
    [MCU.kicad_sch, Power_Management.kicad_sch, RF_Frontend.kicad_sch, User_Interface.kicad_sch, ad8317_powermeter-fixture.dxf, ad8317_powermeter-outline.dxf, ad8317_powermeter-test.dxf, ad8317_powermeter-track.dxf]
2026-08-02 Filter passives and pre-crop Gerbers to simulation domain
    emerge_runner.py:
    - Compute simulation domain as KiCad-coordinate bounding box rectangle
    (Gerber Y-up metres → KiCad Y-down mm). Log the passive filter bbox.
    - Pass sim_domain_outline (rectangle matching simulation domain) to
    PassiveElementModeler instead of the empty board outline_pts. Prevents
    all 49 PCB components from being modelled when no board outline is found;
    only the ~8-12 components inside the port-based simulation area are kept.
    - Pass sim_bounds=(xmin,ymin,xmax,ymax) to load_copper_layers so Gerbers
    are pre-cropped before EMerge sees them.
    gerber_builder.py:
    - Add crop_gerber_to_bbox(): pure-Python Gerber p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
2026-08-02 Fix silent crash + add constructor self-checks and heartbeat pattern
    Root cause: EmergeSolver.__init__ was missing sliver_threshold_mm assignment;
    AttributeError inside run() was swallowed silently, masking itself as a crash.
    - Add _REQUIRED attribute self-check at end of both EmergeModelBuilder and
    EmergeSolver constructors — raises AttributeError immediately at construction
    if any self.* assignment is missing
    - Change ghost face handling from removeEntities() to setTransfiniteSurface +
    setTransfiniteCurve(2) to avoid OCC topology corruption and downstream SEGFAULT
    - Restore occ.synchronize() before apply_region_mesh_sizes() (required ordering)
    - Heartbeat thread (daemon) wrapping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
2026-08-03 Add simple microstrip FEM test with ABC comparison
    Standalone EMerge test (10x5mm FR4, 3mm trace) with:
    - 2nd-order absorbing BCs at X=0/X=BW (--no-abc flag to disable)
    - S-parameter sweep 100MHz–6GHz, Z0 extraction vs Hammerstad-Jensen
    - E/H field plots (XZ, XY, 3D interactive HTML)
    - compare_abc.py: side-by-side S-param and Z0 plots with/without ABC
2026-08-07 EMerge: optimize mesh scope and improve passive parsing
    - Add port_focus_only domain mode with keepout->ports fallback
    - Propagate mesh_copper_z_mm through plugin job config
    - Treat descriptive values like '10k NTC Thermistor' as 10k resistors
    - Make microstrip plotting optional and add geometry/mesh viewers
    - Keep EMerge config + runner behavior aligned for faster focused runs
2026-08-07 Improve EMerge runtime and add headless validation flow
2026-08-07 sim/emerge: SMD series element geometry + passive_modeler notes
    test_microstrip_rlc.py / test_microstrip_rlc_native.py:
    - Both scripts now model a series SMD component in a microstrip gap
    - PCBNew stack: Core + B.Cu only (no solid F.Cu bypass path)
    - Manual trace boxes at z=[pcb.top-TRACE_H, pcb.top] (0.5mm, mesh-resolvable)
    with prio_set(0) to override Core in the overlap region
    - lumped_element(Z_func, size=(RLC_LEN, TW_m)) creates the BC polygon at z=pcb.top
    - *pcb.lumped_elements committed explicitly in commit_geometry()
    - Z_func built from series_impedance/parallel_impedance (EMergeConstants)
    - Result: S11 approx -8.7 dB (expected -9.5 dB for series R=50 Ohm)
    - rlc.py: FreeCAD-exporte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
2026-08-09 Commit all current changes
    [MCU.kicad_sch, Power_Management.kicad_sch, RF_Frontend.kicad_sch, User_Interface.kicad_sch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]
2026-08-09 Fix passive Y transform and add golden E2E baseline outputs
    [ad8317_powermeter-B_Cu.gbr, ad8317_powermeter-B_Mask.gbr, ad8317_powermeter-B_Silkscreen.gbr, ad8317_powermeter-Edge_Cuts.gbr, ad8317_powermeter-F_Cu.gbr, ad8317_powermeter-F_Mask.gbr, ad8317_powermeter-F_Silkscreen.gbr, ad8317_powermeter-In1_Cu.gbr]
2026-08-09 Refine EMerge config UI tabs and hover help behavior
    [ad8317_powermeter-B_Cu.gbr, ad8317_powermeter-B_Mask.gbr, ad8317_powermeter-B_Silkscreen.gbr, ad8317_powermeter-Edge_Cuts.gbr, ad8317_powermeter-F_Cu.gbr, ad8317_powermeter-F_Mask.gbr, ad8317_powermeter-F_Silkscreen.gbr, ad8317_powermeter-In1_Cu.gbr]
2026-08-09 Add drill/via import support and update golden EMerge artifacts
    [ad8317_powermeter-B_Cu.gbr, ad8317_powermeter-B_Mask.gbr, ad8317_powermeter-B_Silkscreen.gbr, ad8317_powermeter-Edge_Cuts.gbr, ad8317_powermeter-F_Cu.gbr, ad8317_powermeter-F_Mask.gbr, ad8317_powermeter-F_Silkscreen.gbr, ad8317_powermeter-In1_Cu.gbr]
2026-08-09 Refine EMerge labels/colors and passive naming; sync artifact set
    [ad8317_powermeter-B_Cu.gbr, ad8317_powermeter-B_Mask.gbr, ad8317_powermeter-B_Silkscreen.gbr, ad8317_powermeter-Edge_Cuts.gbr, ad8317_powermeter-F_Cu.gbr, ad8317_powermeter-F_Mask.gbr, ad8317_powermeter-F_Silkscreen.gbr, ad8317_powermeter-In1_Cu.gbr]
2026-08-09 Fix via geometry/mesh visibility and update plugin icon
    [ad8317_powermeter-B_Cu.gbr, ad8317_powermeter-B_Mask.gbr, ad8317_powermeter-B_Silkscreen.gbr, ad8317_powermeter-Edge_Cuts.gbr, ad8317_powermeter-F_Cu.gbr, ad8317_powermeter-F_Mask.gbr, ad8317_powermeter-F_Silkscreen.gbr, ad8317_powermeter-In1_Cu.gbr]
2026-08-09 Add 2026-08-10 golden EMerge baseline artifacts
    [ad8317_powermeter-B_Cu.gbr, ad8317_powermeter-B_Mask.gbr, ad8317_powermeter-B_Silkscreen.gbr, ad8317_powermeter-Edge_Cuts.gbr, ad8317_powermeter-F_Cu.gbr, ad8317_powermeter-F_Mask.gbr, ad8317_powermeter-F_Silkscreen.gbr, ad8317_powermeter-In1_Cu.gbr]
2026-08-10 DRD Rev B: sync to schematic, add RF connector/PDN/schematic review sections
2026-08-12 Add HFSS SMA-to-GCPW optimization coupon script and design document
    hfss_sma_coupon_gcpw_opt.py: IronPython 2.7 half-model coupon with LC
    compensation network (4 variables), kDX ASO optimizer (Adaptive
    Single-Objective), three-step Optimetrics API (InsertSetup + ChangeProperty
    + EditSetup), DiscreteValues frequency list for the goal range, and
    ParametricSetup1 sensitivity scan. API strings and DXOptimizerOptionData
    fields confirmed by AEDT 2026.1 script recorder.
    hfss_sma_coupon_gcpw_opt.md: design document covering layer geometry,
    variable bounds, all available AEDT optimizer methods with API strings,
    three-step InsertSetup pattern, and optimizer option dialog values.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
2026-08-12 Add base HFSS SMA coupon scripts (coaxial and GCPW variants)
    hfss_sma_coupon.py: full two-connector coaxial SMA coupon, uniform trace.
    hfss_sma_coupon_gcpw.py: full two-connector GCPW coupon, uniform trace,
    via fence, coplanar GND strips. Both serve as reference baselines and
    code templates for hfss_sma_coupon_gcpw_opt.py.
2026-08-13 Fix SOLVER_OUT_OF_MEMORY in all HFSS coupon scripts
    Reduce MAX_PASSES 20→10 and restrict skin-depth mesh op to the signal
    trace only (was applied to all copper including large inner planes).
    A 20x10mm plane at 0.15mm surface elements generates ~90k surface
    triangles x 2 skin-depth layers = ~180k tets per plane; three planes
    across 20 adaptive passes exhausted RAM on the local solver machine.
    Inner planes carry diffuse return current that HFSS adaptive refinement
    handles correctly without an explicit skin-depth op.
    Also raise MESH_SKIN_MM 0.035→0.10mm on the trace-only skin-depth op.
    Applies to: hfss_sma_coupon.py, hfss_sma_coupon_gcpw.py,
    hfss_sma_coupon_gcpw_opt.py
    Co-Aut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
2026-08-13 Fix AssignLumpedRLC and CreateFieldPlot API calls for AEDT 2026.1
    AEDT IronPython 2.7 rejects unit-suffixed strings ("50ohm") in
    AssignLumpedRLC, treating them as zero — triggering "At least one of
    R/C/L must be defined." Changed Resistance/Inductance/Capacitance
    values to plain numbers ("50", "0", "0").
    CreateFieldPlot Jsurf failed because "ObjList" was renamed to "Objects"
    in AEDT 2026.1, and IntrinsicVar values must not be single-quoted
    ("Freq=16GHz" not "Freq='16GHz'").
2026-08-23 Fix port-focused geometry scope leak and mesh retry diagnostics
    - Add detailed mesh attempt parameters logging: entity counts, CLmax, curved_boundary, extra constraints
    - Log full exception type and traceback on mesh failure
    - Log GMSH state (nodes, elements) after failed mesh attempt
    - Remove curved_boundary_meshing() mutation during generic HXT recovery that was corrupting EMerge internal state and causing IndexError on retry
    - Invert fallback condition: only use full Gerber fallback when NO domain scope (sim_bounds) is set
    - Prevents silent scope boundary violation where cropped Gerber parse errors would load full uncropped geometry
    - Add explicit par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
2026-08-23 Fix region geometry leak in Gerber crop: keep only regions entirely within bounds
    gerber_builder.py crop_gerber_to_bbox():
    - Inverted region inclusion logic: now assumes regions are in-box, sets to False if ANY vertex is OUTSIDE
    - Before: kept entire region if any vertex was in-box (silently reintroduced full-board copper pours)
    - After: keeps only regions where ALL vertices are within crop boundary
    - Prevents large inner-layer copper planes from extending beyond port-focused simulation domain
    This was the root cause of geometry expanding from requested 19x10mm port window to 97x42mm full board.
2026-09-16 Use Würth 60312202114307 SMA connector
    Replace J1 with the shorter Würth WR-SMA connector, add its footprint and 3D model, make KiCad library paths portable, and include the reviewed EMerge geometry/export updates. Generated results and private local paths are intentionally excluded.
    [RF_Frontend.kicad_sch, ad8317_powermeter.kicad_pcb]
2026-10-09 Add S11 analysis of J1 -> AD8317 input (1 MHz - 10 GHz)
    - AD8317 INHI-INLO input model from the datasheet R||C table (s1p, series s2p)
    - Qucs netlists: rfsim 3-port + chip, and a circuit-level model of the board
    - Study script, results CSV/plot, and write-up incl. rfsim port-reference finding
    (In1/In2 void by design, ports must reference B.Cu / saved stackup)
    - RF_Input_Optimization_Plan.md: update note and item 3 status
    [s11_results.csv]
2026-10-09 S11 study: chip model variants, Touchstone I/O fixes, copper-missing root cause
    - ad8317_input_model: table/hold/chart variants, chart point at 10 GHz
    - s3p_io: ports from extension, option parsing, clear errors, wrapped writer, tests
    - run_s11_study: qucsator discovery, robust error check, --rfsim, B_chart case
    - drop obsolete generic_stackup results and tracked .dat files
    - doc: second root cause (all copper dropped by openEMS because of averaged z
    mesh lines), results after the fix, CPW test
    [s11_results.csv]
2026-10-09 Add sensitive-data check, RF input targets, optimiser and substrate-defined line models
    - tools/check_sensitive.py + install_githooks.py: pre-commit / pre-push check for personal data,
    local paths and secrets (own strings stay in .git/sensitive-patterns.txt, never committed)
    - sim/qucs: substrate-defined CPW/microstrip cases C1..C4, geometry optimiser, schematic generator
    - doc: RF input targets vs lab power meters, S11 analysis results
    - generic defaults instead of machine-specific paths (qucsator, EMerge plugin build/sync)
    - .gitignore: local-only settings, generated schematics and results
    [s11_results.csv]
2026-10-09 Compare ADL5507 with AD8317: S-parameter model, Qucs cases, analysis
    - adl5507_input_model.py: RFIN model from datasheet Tables 4 and 5 (bare pin
    and with 51 ohm), written as 1-port Touchstone files, 1 MHz - 10 GHz
    (extrapolated below 10 MHz).
    - run_adl5507_study.py: chips alone and J1 -> chip on four stackups
    (drop-in on the AD8317 front end, ADI reference with 51 ohm, Table 4),
    with the AD8317 on the same lines; CSV, plots and tables.
    - make_qucs_schematics.py: 1-port SPfile, generic chain drawing, schematics
    for the new cases; all schematics verified against the netlists.
    - run_s11_study.py: line, step and netlist builders moved to module level
    (netlists of the existing cases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
    [adl5507_vs_ad8317.csv]
2026-10-23 Add Teko 435 shield footprint, Hammond 1590A 3D model, front foil and button levers
    - lib: Teko 435 RF shield footprint + STEP, Hammond 1590A STEP with footprint link,
    Laird footprint description without URL
    - mech: front foil for the 1590A lid (DXF, A4 colour print PDF, feed test sheet, BOM,
    generator), printed lever mechanism for SW1/SW2 under the OLED module (levers,
    U bracket, STEP/STL, interference and stiffness checks), machined case STEP,
    CNC DXF set-ups for lid window/post holes and SMA/USB-C end walls with tool data
2026-10-23 Update KiCad project, Wurth SMA library and S11 simulation work
    - kicad: schematic/PCB/DRU/project updates, JLCPCB production files, removed obsolete
    fixture drawings and xml export
    - lib: Wurth WR-SMA footprints and 3D models (SMD and THT), library disclaimer
    - sim: AD8317 input S11 Touchstone files, Qucs cases, HFSS SMA coupon scripts
    - doc: instrument and component reference PDFs
    emerge_results/ and generated HTML reports are intentionally not included.
2026-11-06 Update SMA launch footprint and RF PCB layout; HFSS verification pending
    Snapshot of the updated source PCB, KiCad settings and custom SMA footprint. No new simulation results are included. DRC and HFSS validation remain pending; not a fabrication sign-off.
2026-11-06 Add GND to U1 pad 9, relax DRC rules, refresh JLCPCB outputs; HFSS verified
    - U1 exposed pad 9 on GND with 4 GND vias and the F.Cu pour; vias removed from the In1 antipad
    - All 30 J1 PTH GND pads connected to the GND pours (GND_zone_edge_0p3 rule)
    - DRC rules cleaned up: EMC rules removed, solder_mask_bridge set to warning;
    kicad-cli DRC with refill: 0 errors, 0 unconnected, 226 warnings
    - JLCPCB gerbers, drill files, BOM and CPL regenerated
    HFSS 2026 R1, full 7-port board model, HPC job 4251, converged:
    - Isolated SMA transition 307_b0: S11 <= -25.6 dB up to 10 GHz
    - Full loaded path SMA -> AD8317: S11 <= -16.4 dB at 0.1-1 GHz,
    worst -1.30 dB at 8 GHz, mean -8.13 dB (rev. e24b8f3: -6.9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
2026-11-06 Add HFSS verification results for PCB revision d70857a
    - 7-port S-parameters (HPC job 4251, converged, delta S 0.0033) and solution check
    - Revision report and SMA -> PCB -> AD8317 report (PDF)
    - Circuit study of resistor/capacitor options on the unchanged layout:
    replacing parts alone changes worst S11 by less than 0.5 dB; layout is the limit
    - RF line geometry/Z0 and GND stitching audits, post-processing scripts
    RF line: CPWG on F.Cu over In1 GND, 0.10 mm FR4 prepreg, J1-In 0.15 mm,
    top GND gap 0.16-0.71 mm; bare copper under ENIG, ENIG not modelled.
2026-11-13 KiCad: snapshot of the AD8317 power-meter board before the SMA connector-edge ground optimisation
    State of the KiCad project as it stands (board, schematic, project and local settings) so that the current design stays
    reproducible while the connector cutout, solder-mask openings and In1/B.Cu ground continuity are being optimised.
    The HFSS revision pcb_wip_eabc372b was built from an earlier save (PCB sha256 eabc372b..., 2026-11-09); this commit holds the
    later save of 2026-11-11 (sha256 664dff77...). Difference in the RF area: only the outline of the F.Cu ground zone.
    Not included: emerge_results outputs, DRD notes, generated HTML reports.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
